lahirunirmalx/discrete-stereo-amp/README.md

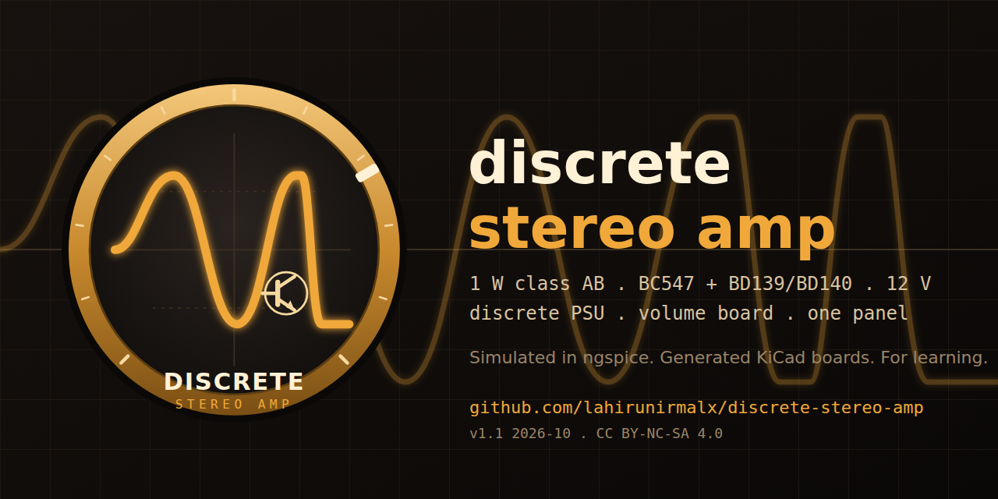
[picture p1: docs/images/banner.png]
discrete stereo amp


# Stereo class-AB amplifier, discrete 12 V supply, volume and headphone boards

A hobby / learning project: a two-channel 1 W class-AB amplifier built from BC547/BC557/BD139/BD140,
its own transformer-fed discrete supply, a volume board and a headphone board, all on one fab panel. It grew
out of a review of a one-transistor "speaker in the collector" amp, which could not be fixed by changing
values. Every number here comes from ngspice; **no board has been built or measured yet** (revision 1.3 is a
prototype design). Release 2 rebuilt the amp front end for ten times less distortion, closed the supply's
regulation loop, added a VU meter tap and the headphone board. Revision 1.3 is the result of a second design
review: an output inductor for stability into capacitive loads, a fail-safe bias trimmer, input protection on
the amp, a correctly sized supply fuse and a headphone switch rated for speaker current.

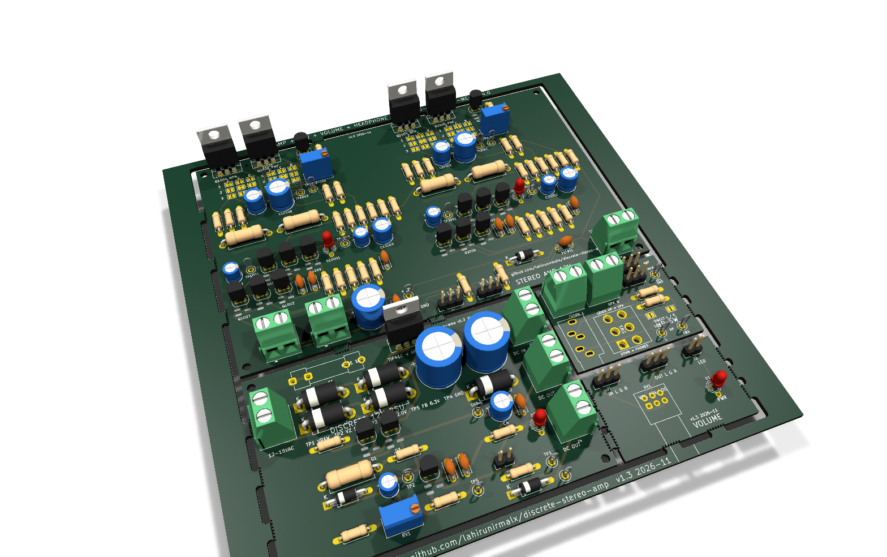
[picture p2: docs/images/panel_3d_iso.png]
Panel, 3D


| Amp | PSU | Volume | Headphone |
|---|---|---|---|
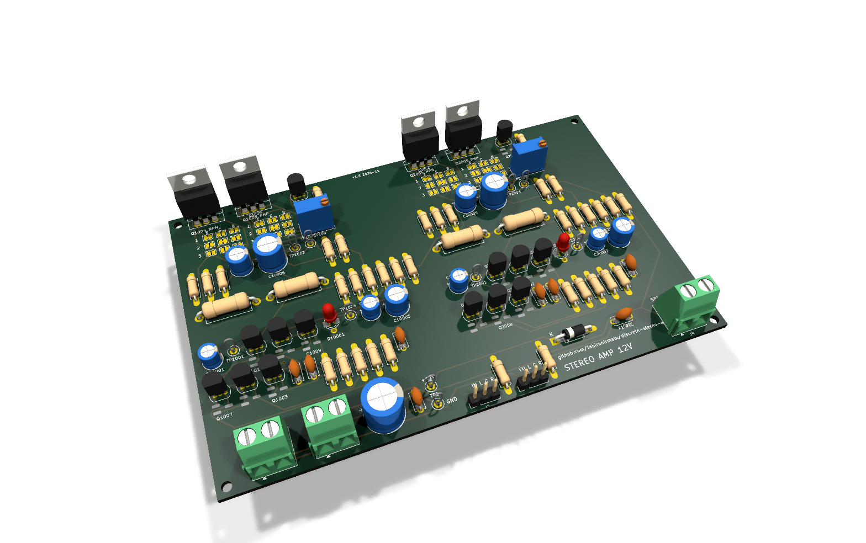
[picture p3: docs/images/amp_3d_iso.png]
Amp 3D
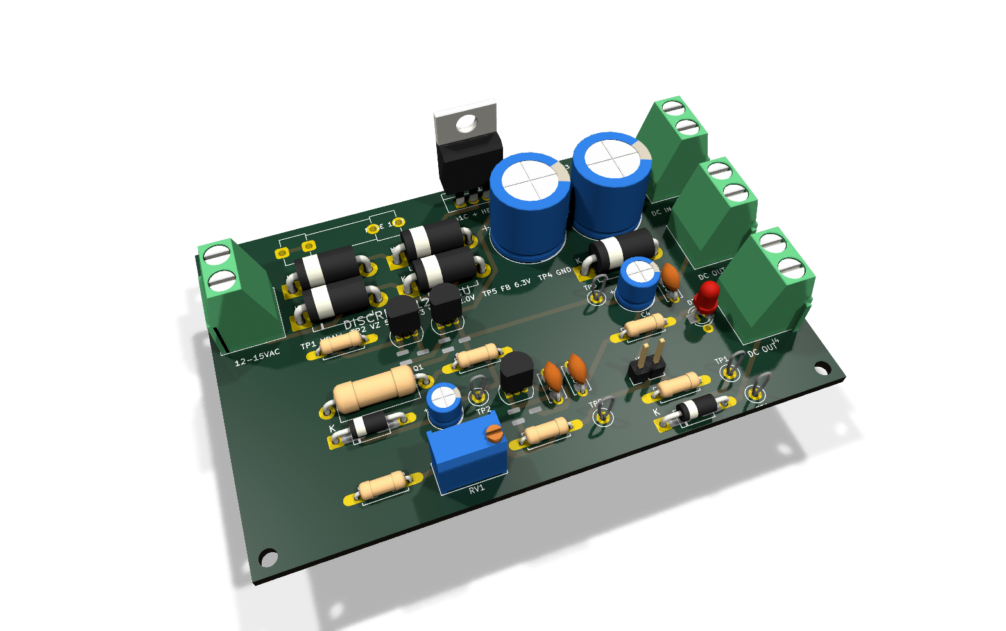
[picture p4: docs/images/psu_3d_iso.png]
PSU 3D
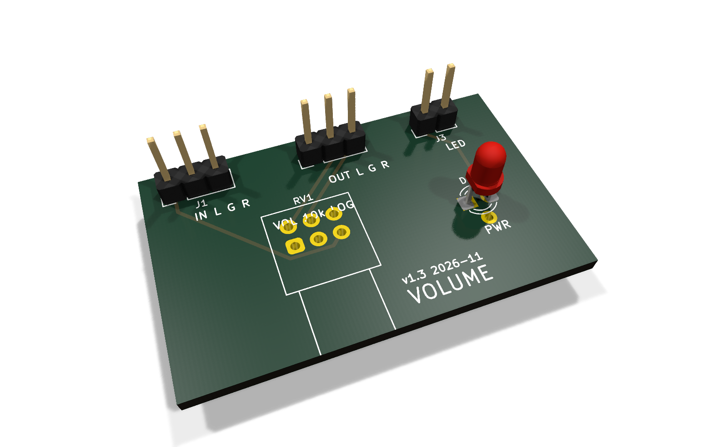
[picture p5: docs/images/vol_3d_iso.png]
Volume 3D
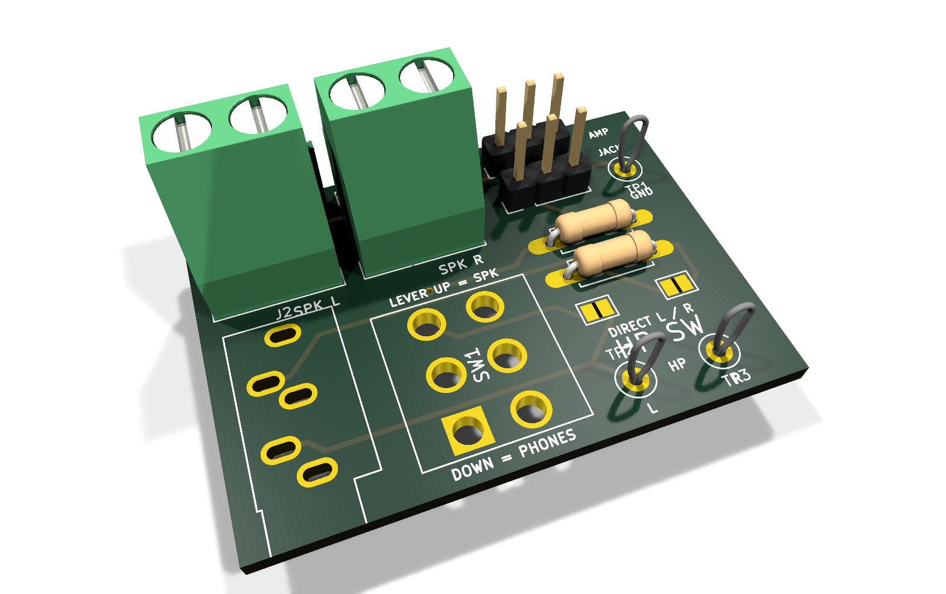
[picture p6: docs/images/hp_3d_iso.png]
Headphone 3D
|  |  |  |  |

More views in [docs/images/](docs/images/): top-down 3D renders and the single-sided layouts. Logo and banner: `logo.svg` / `logo.png` / `logo-1024.png` and `banner.svg` / `banner.png` (1280 x 640, the GitHub social-preview size).

## Schematics

| Amp (both channels) | PSU | Volume | Headphone |
|---|---|---|---|
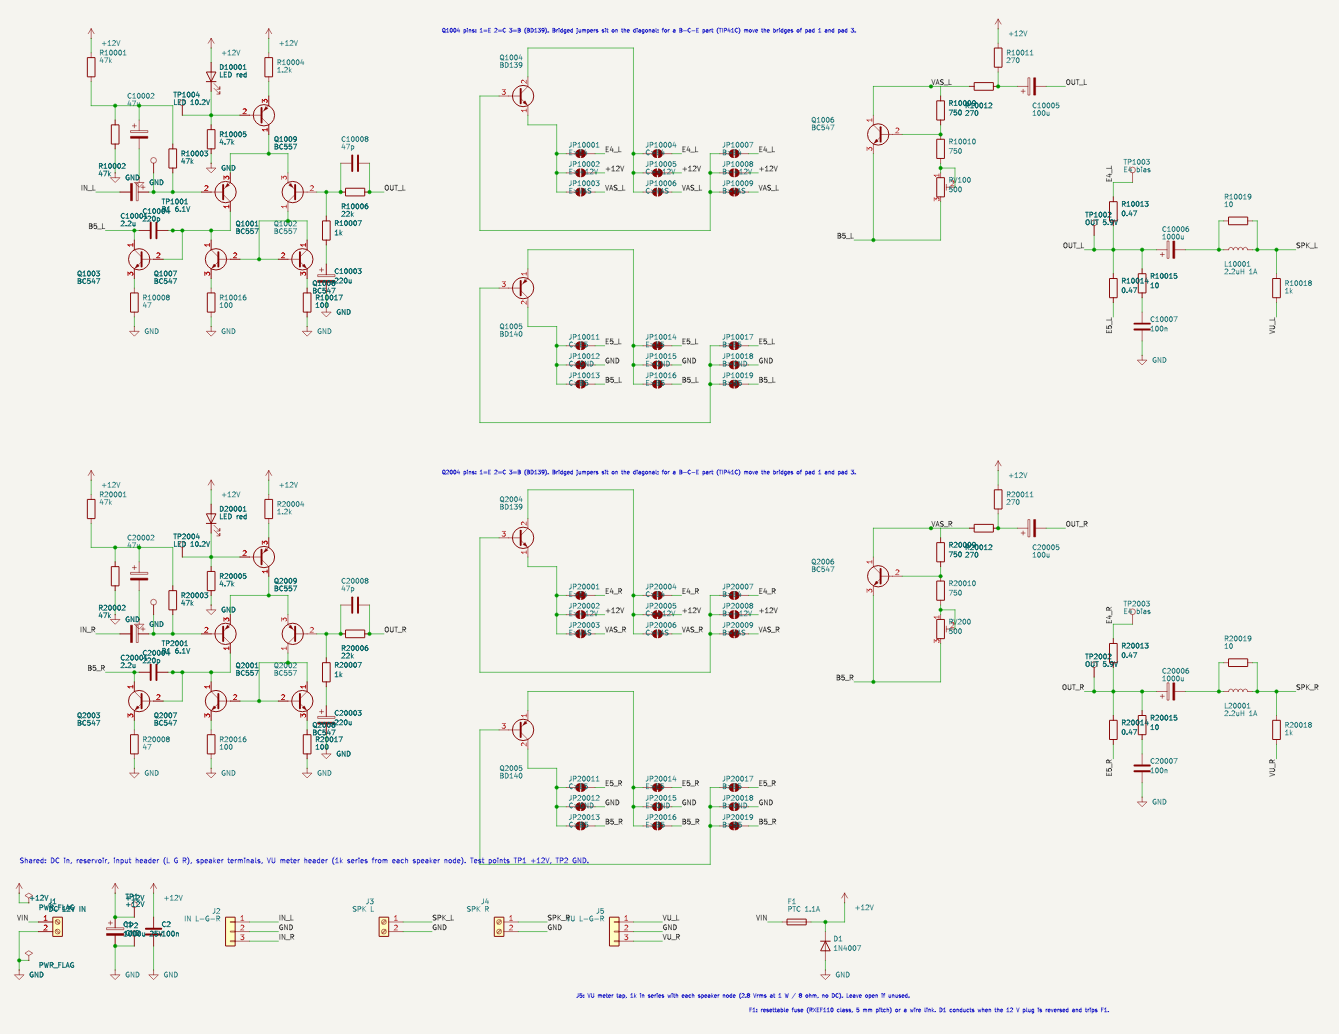
[picture p7: docs/images/amp_schematic.png]
Amp schematic
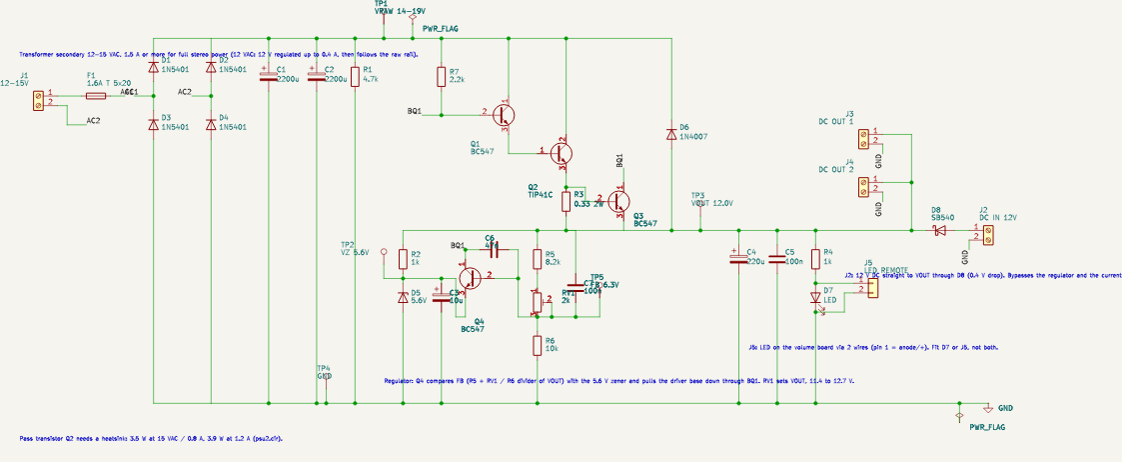
[picture p8: docs/images/psu_schematic.png]
PSU schematic
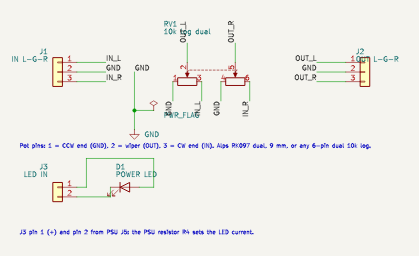
[picture p9: docs/images/vol_schematic.png]
Volume schematic
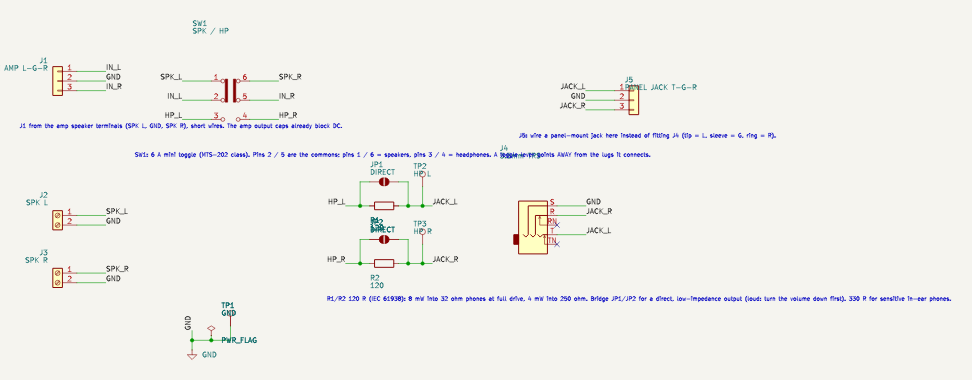
[picture p10: docs/images/hp_schematic.png]
Headphone schematic
|  |  |  |  |

PDFs of all four are in the release zip (`schematics/`).

## Boards (2-layer layouts, top view, both copper layers)

| Amp, wide 134 x 86 mm | Amp, compact 100 x 98 mm | PSU 90 x 58 mm | Volume 42 x 26 mm | Headphone 42 x 30 mm |
|---|---|---|---|---|
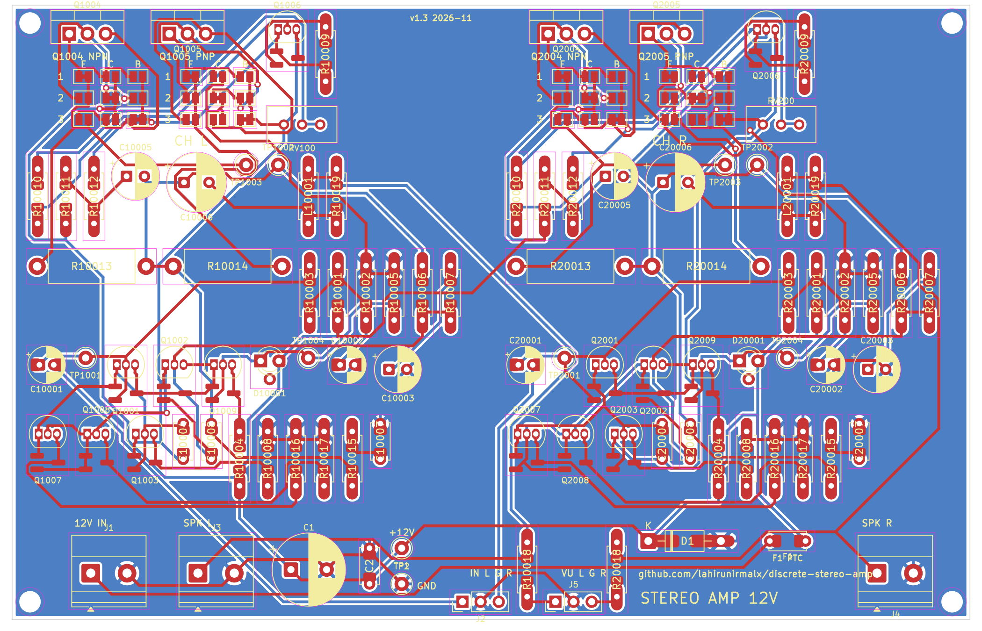
[picture p11: docs/images/amp_pcb_2layer.png]
Amp PCB
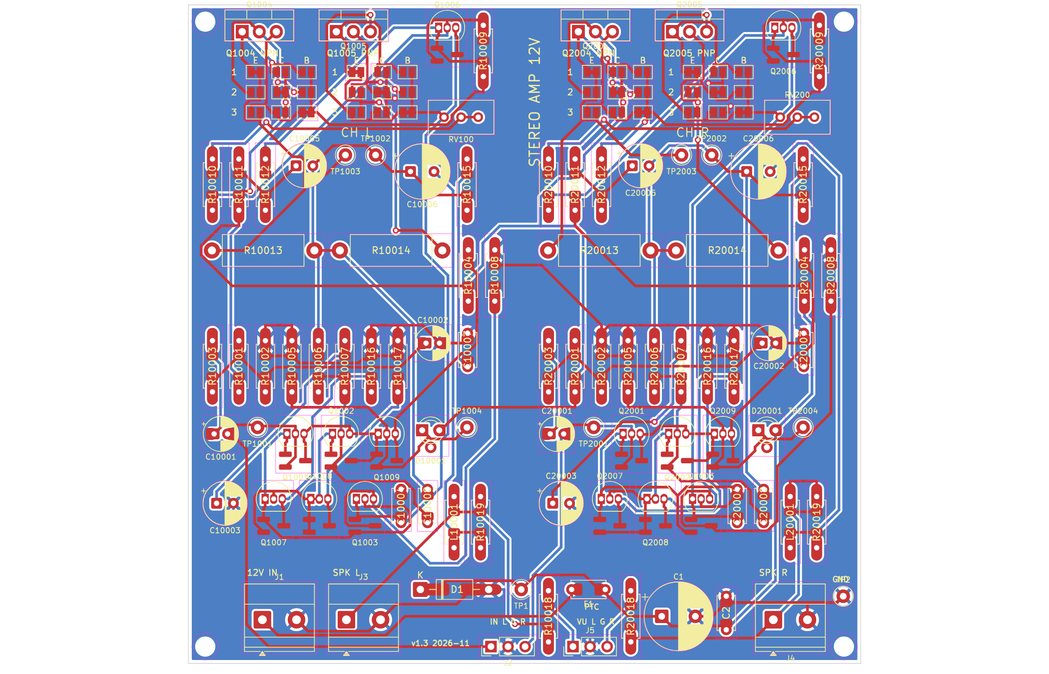
[picture p12: docs/images/amp_compact_pcb_2layer.png]
Compact amp PCB
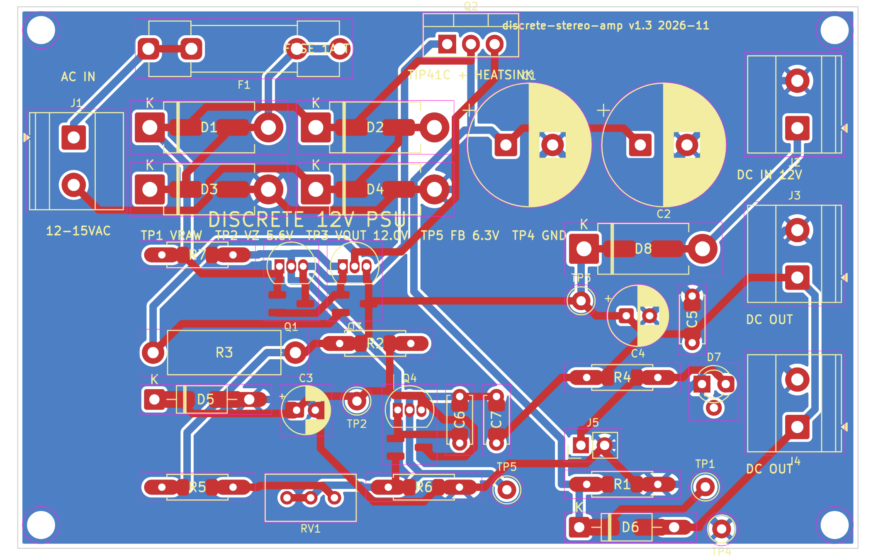
[picture p13: docs/images/psu_pcb_2layer.png]
PSU PCB
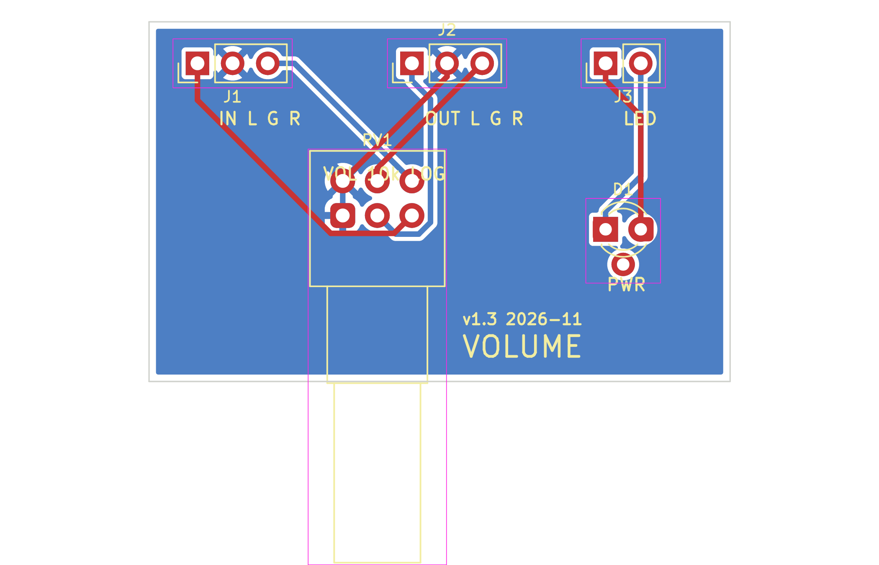
[picture p14: docs/images/vol_pcb_2layer.png]
Volume PCB
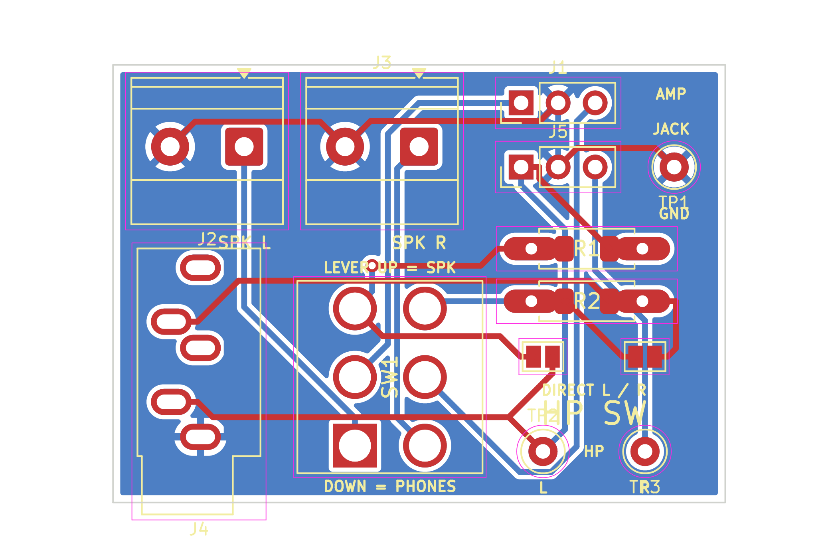
[picture p15: docs/images/hp_pcb_2layer.png]
Headphone PCB
|  |  |  |  |  |

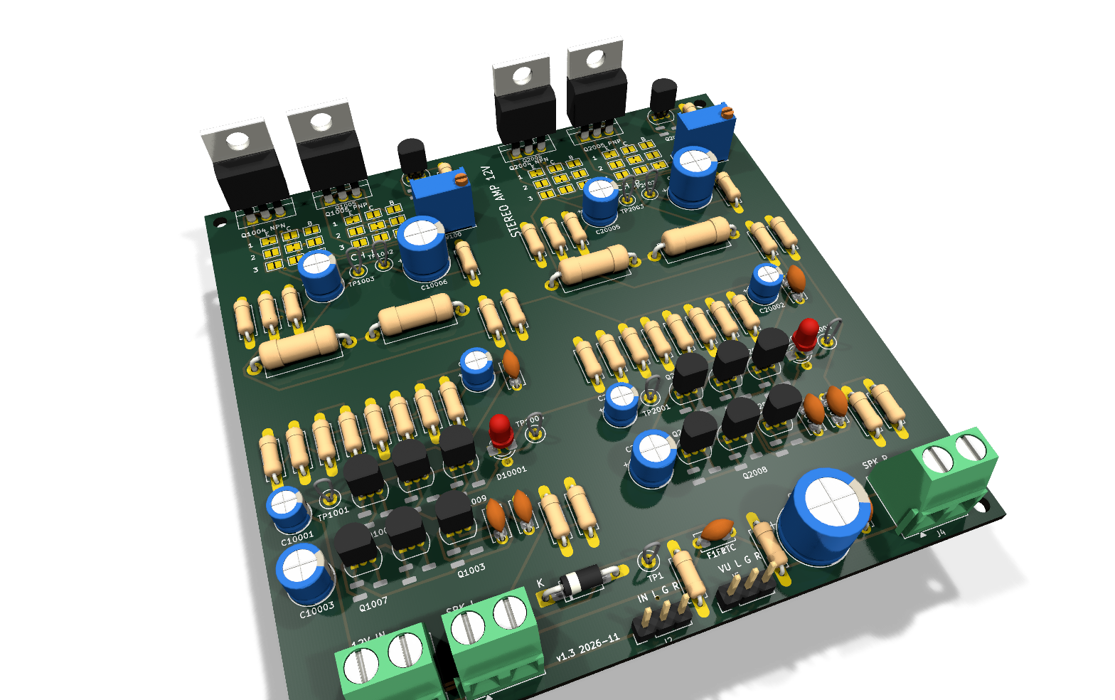
[picture p16: docs/images/amp_compact_3d_iso.png]
Compact amp 3D


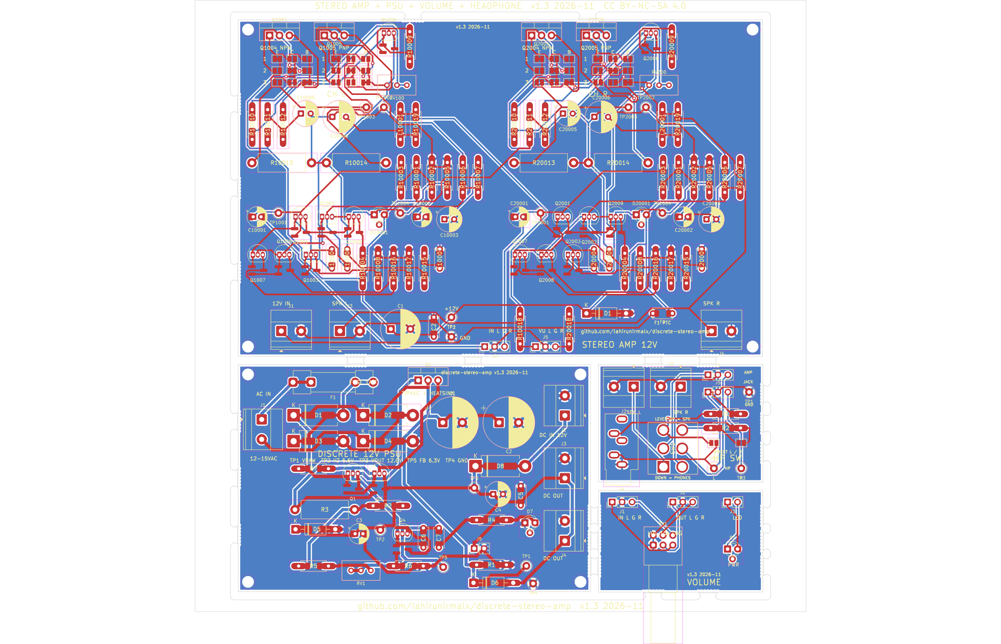
[picture p17: docs/images/panel_2layer.png]
Panel layout


## What it does

| | |
|---|---|
| Output | 1.2 W into 8 ohm and 1.5 W into 4 ohm at the onset of clipping (per channel, 12 V); 0.29 W into 8 ohm at 0.02 to 0.05% THD, 52 mW into 4 ohm at 0.013% |
| Gain / input | 23 (27 dB), 46k input impedance, for a 10k log pot |
| Idle current | output stage 21 mA per channel after setting the trimmer (7 to 10 mV across a 0.47 ohm emitter resistor; trimmer range 2 to 70 mA); about 33 mA per channel from the supply |
| Bandwidth | 20 Hz (8 ohm) / 34 Hz (4 ohm) to 108 kHz, -0.13 dB at 20 kHz |
| Stability | loop phase margin 65 degrees or more for any load from open to 2.2 uF (2.2 uH + 10 ohm output inductor) |
| Protection | amp: resettable fuse + reverse-polarity diode on the 12 V input, bias trimmer limited to 70 mA and fail-safe; PSU: 2 A clamp + 1.6 A slow fuse |
| Supply | 12 to 15 VAC transformer (1.5 A for full power) or 12 V DC in; closed-loop 12.0 V out (trimmer 11.4 to 12.7 V), 0.14 V dip on a 1 A step, 2 A clamp |
| Headphones | DPDT toggle switch speakers / phones, 120 ohm series (8 mW into 32 ohm), DIRECT jumpers, 3.5 mm jack or panel jack header |
| VU meter | 1x3 header on the amp, 1k in series with each speaker node (2.8 Vrms at 1 W) |
| Boards | amp 134 x 86 mm (or the compact 100 x 98 mm variant for the 100 x 100 fab tier), PSU 90 x 58 mm, volume 42 x 26 mm, headphone 42 x 30 mm; 2-layer panel 156 x 156 mm; single-sided variants |
| Parts | 151 through-hole parts with 1206 / SOD / SMA / SOT-23 twins on the same pads; 38 solder jumpers (output pinouts, headphone DIRECT) |

## Design rules this project keeps

1. **Modular.** Every board works alone; none depends on another. Build the amp only, add the volume board or the PSU later.
2. **Your parts, your build.** Every passive has through-hole pads plus a 1206 / SOD / SMA twin; every output transistor sits behind a 3x3 solder-jumper pinout block; the BOM lists at least three substitutes per transistor. Fit what you have.
3. **Debuggable by a beginner.** Every board carries labelled test points with the expected voltage printed next to them, and the bring-up guide walks through them in order.

Any change to this project is checked against these three before it is merged.

## Build it board by board

Every board works on its own; nothing is required by another board.

| You build | You need | What you get |
|---|---|---|
| Amp only | any 12 V DC supply of 1 A (wall adapter, bench supply) into "12V IN"; a phone, PC or DAC into the "IN L G R" header; speakers on the terminals | a working stereo amp; the source's own volume control sets the level (a phone at full volume will clip, so turn it down) |
| Amp + volume board | as above, plus the two 3-pin cables | a volume knob (and the front-panel LED position) |
| Amp + PSU | a 12 to 15 VAC transformer into the PSU, or 12 V DC into its "DC IN"; PSU "DC OUT" to the amp | a regulated, clamped, fused supply with the power LED |
| Amp + headphone board | three wires from the amp's speaker terminals to "FROM AMP", speakers on the headphone board's terminals | a speakers / phones switch and a jack |
| VU meters | any meter on the amp's "VU L G R" header | level display; nothing else changes |
| All four | the panel | the complete desk amp |

Two amp layouts carry the same circuit: the wide one (134 x 86 mm, matches the PSU plus headphone-and-volume
column on the panel) and the compact one (100 x 98 mm, fits JLCPCB's 100 x 100 mm tier when ordered alone).
Choose by price; there is no electrical difference.

## Documents

1. [docs/01-theory-of-operation.md](docs/01-theory-of-operation.md): every block explained for a first build, with the voltages to expect.
2. [docs/02-simulation-results.md](docs/02-simulation-results.md): all the ngspice tables, including the rejected candidates, the release 2 front end and supply (2.7 to 2.9) and the revision 1.3 loop-gain work (2.10).
3. [docs/03-design-review.md](docs/03-design-review.md): what was checked, what was found, what is not verified.
4. [docs/04-build-and-bringup.md](docs/04-build-and-bringup.md): assembly order, first power-up, bias setting, test points, troubleshooting.
5. [ORDER_GUIDE.md](ORDER_GUIDE.md): ordering the panel, substitutes, matching, tolerances.
6. [docs/05-preamp-study.md](docs/05-preamp-study.md): does a preamp stage help a line-level desk amp? (No; where it would.)
7. [docs/KNOWN_ISSUES.md](docs/KNOWN_ISSUES.md) and [docs/CHANGELOG.md](docs/CHANGELOG.md).
8. Interactive: [amp channel in CircuitJS](https://www.falstad.com/circuit/circuitjs.html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,%20VAS,%20Vbe%20multiplier,%20BD139/BD140.%2012%20V,%20Iq%2021%20mA,%201%20W%20into%208R%20at%200.5%25%20THD%0A), [power supply in CircuitJS](https://www.falstad.com/circuit/circuitjs.html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) (text netlists in [docs/circuitjs/](docs/circuitjs/)).
9. [docs/stereo-amp-notes.html](docs/stereo-amp-notes.html): single-file bench-notes page with the verified figures, every sweep table and links to interactive CircuitJS versions of the channel and the supply (download and open locally, or view it through htmlpreview.github.io).

## Files

| Dir | What |
|---|---|
| `sim/` | ngspice decks and results (`sim/README.md`) |
| `kicad/gen_amp.py gen_psu.py gen_vol.py gen_hp.py` | schematic generators (kisch.py writer, common.py helpers and the STAMP); `netcheck.py` proves each netlist matches its deck |
| `kicad/gen_pcb_*.py`, `pcbgen.py` | placement + board builder (hybrid footprints, 2-layer or `--single`) |
| `kicad/build.sh <board> [--single] [--compact]` | place, freerouting (second pass if needed), ground pour, DRC, PNG |
| `kicad/panel/` | KiKit multi-design panel, BOMs (bom_all, bom_shopping, bom_mouser) |
| `kicad/release.sh` | fab package -> `release/stereo-amp-release-<date>.zip` |
| `docs/` | the documents above and `docs/images/` |
| `analysis/` | check-schematic / check-pcb analyzer outputs used by the design review |
| `build_all.sh` | regenerate everything |

Schematic symbol UUIDs are deterministic, so re-running a generator keeps PCB parity. Edit the generators,
not the KiCad files.

## Status

Revision 1.3, 2026-11-10: design complete, simulated, reviewed twice, DRC clean (2-layer boards and panel), unbuilt. The
single-sided amp board needs hand finishing (see known issues).

## License

[CC BY-NC-SA 4.0](LICENSE): build it, modify it, share it with credit; no commercial use of this or any
derived design without the author's written permission.
