lahirunirmalx/discrete-stereo-amp/docs/images/amp_3d_top.png

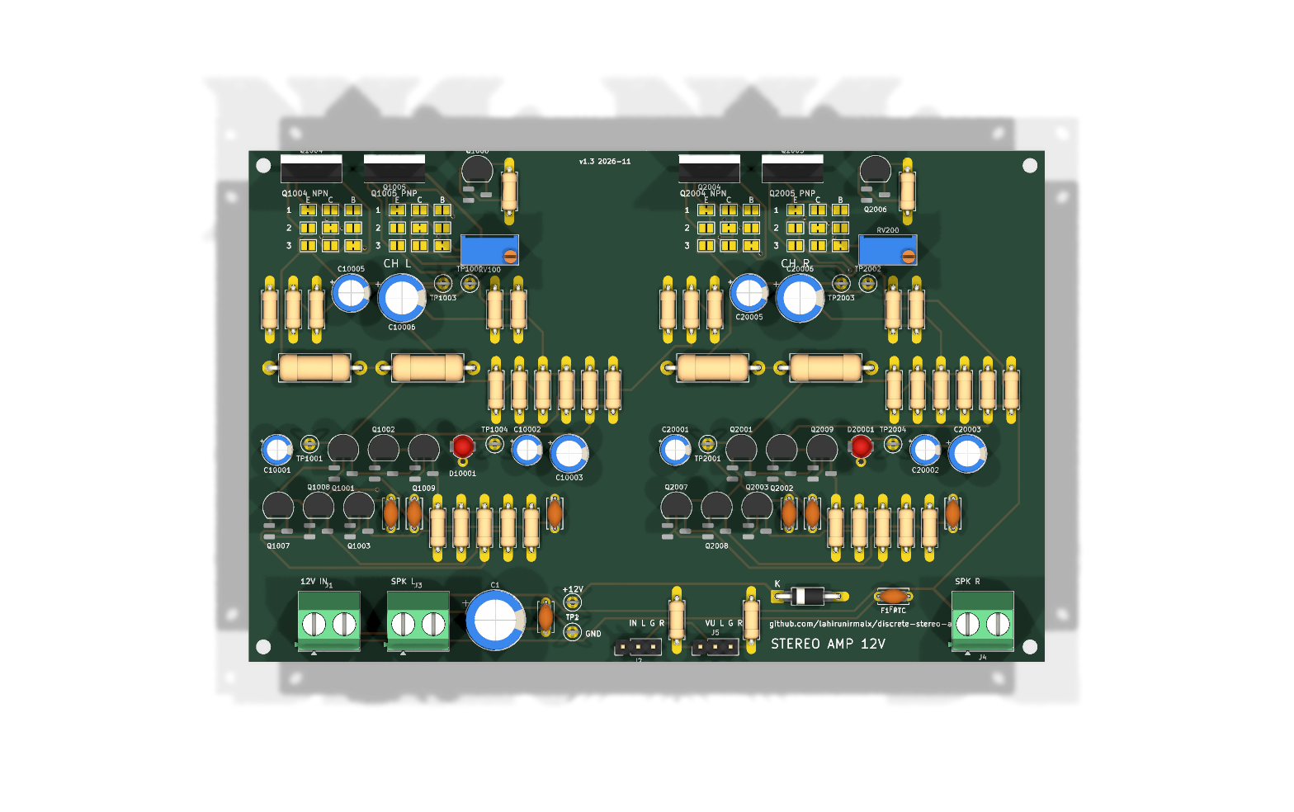
docs/images/amp_3d_top.png
