lahirunirmalx/discrete-stereo-amp/docs/images/amp_pcb_1layer.png

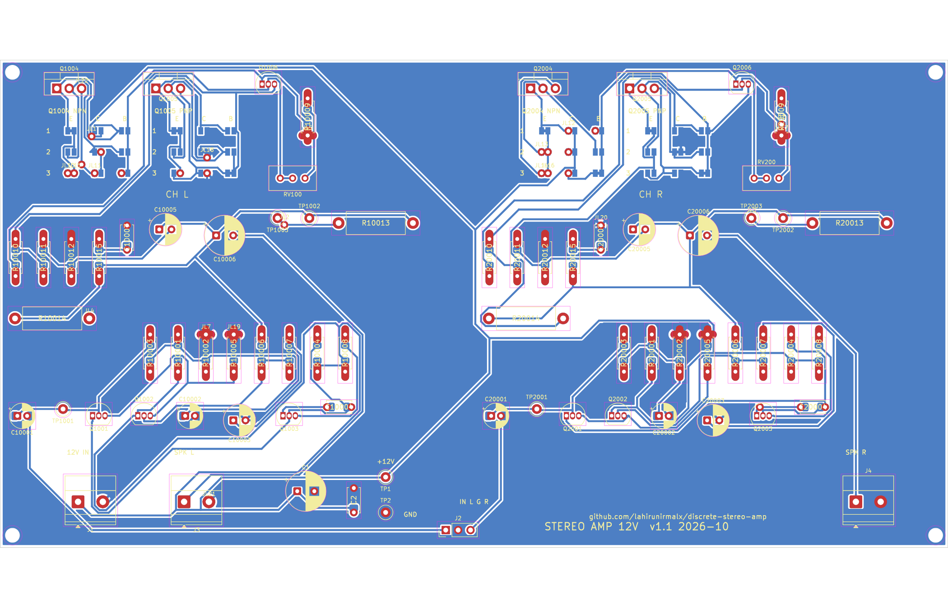
docs/images/amp_pcb_1layer.png
