lahirunirmalx/discrete-stereo-amp/docs/images/hp_3d_top.png

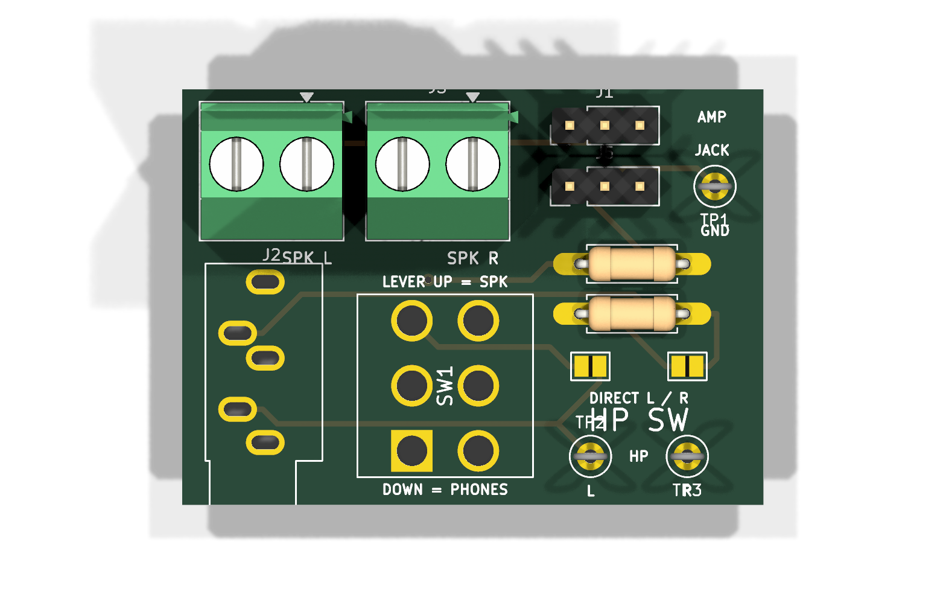
docs/images/hp_3d_top.png
