lahirunirmalx/discrete-stereo-amp/docs/images/hp_pcb_1layer.png

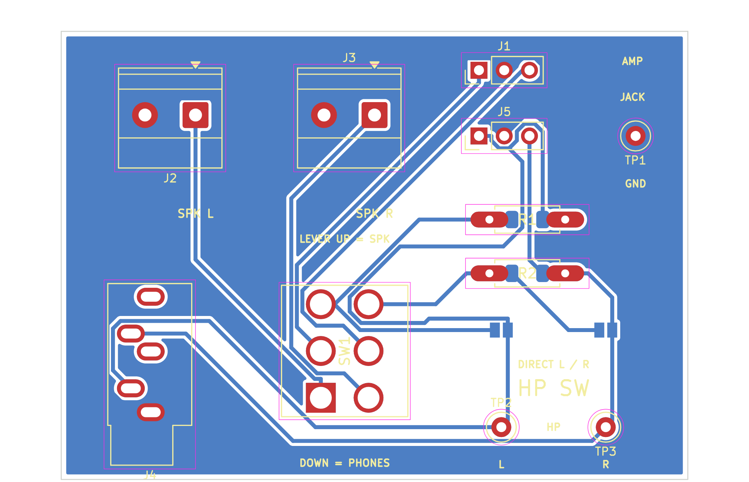
docs/images/hp_pcb_1layer.png
