lahirunirmalx/discrete-stereo-amp/docs/images/panel_3d_top.png

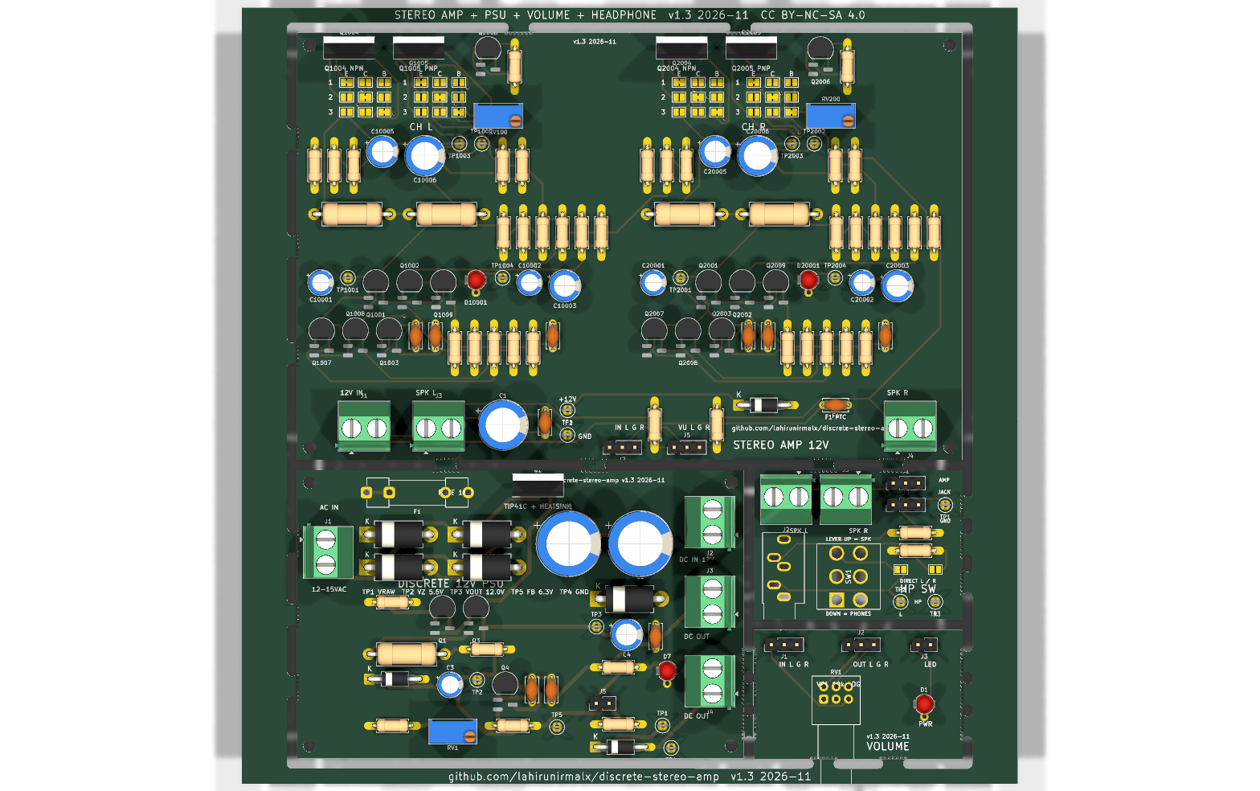
docs/images/panel_3d_top.png
