lahirunirmalx/discrete-stereo-amp/docs/images/psu_3d_top.png

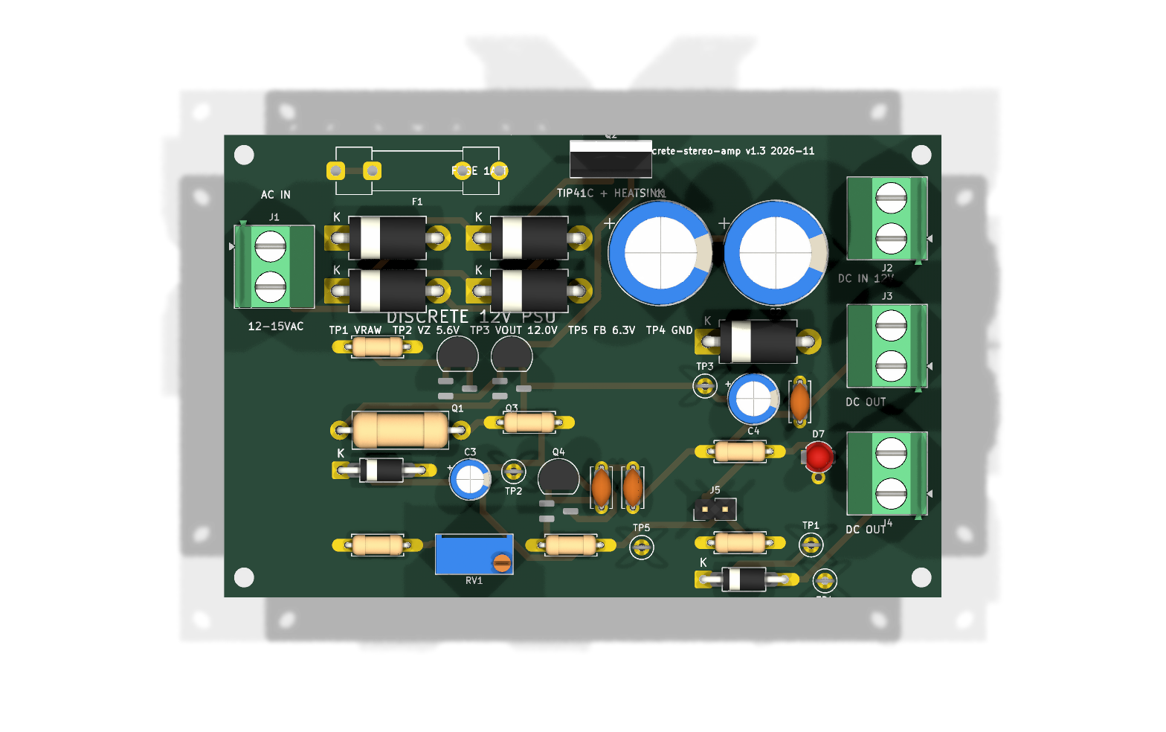
docs/images/psu_3d_top.png
