lahirunirmalx/discrete-stereo-amp/docs/images/psu_pcb_1layer.png

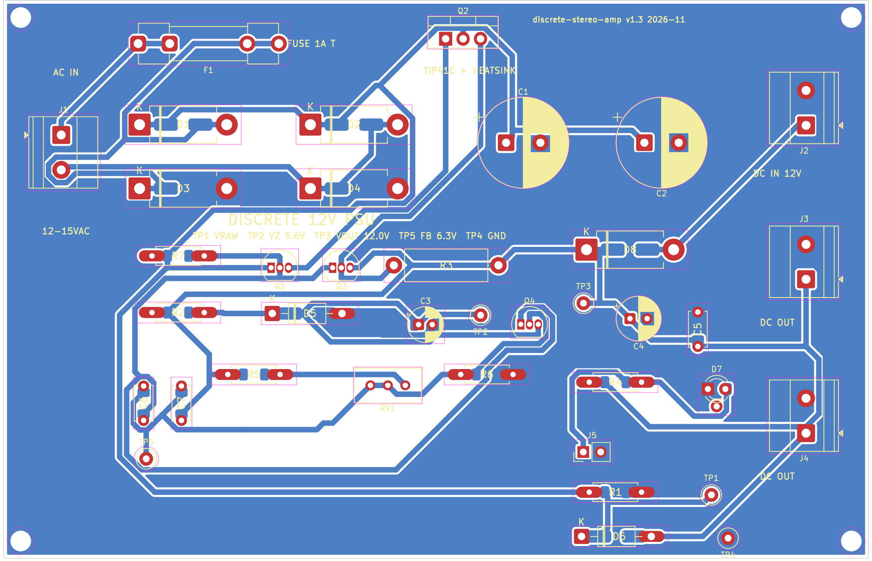
docs/images/psu_pcb_1layer.png
