lahirunirmalx/discrete-stereo-amp/docs/images/vol_3d_top.png

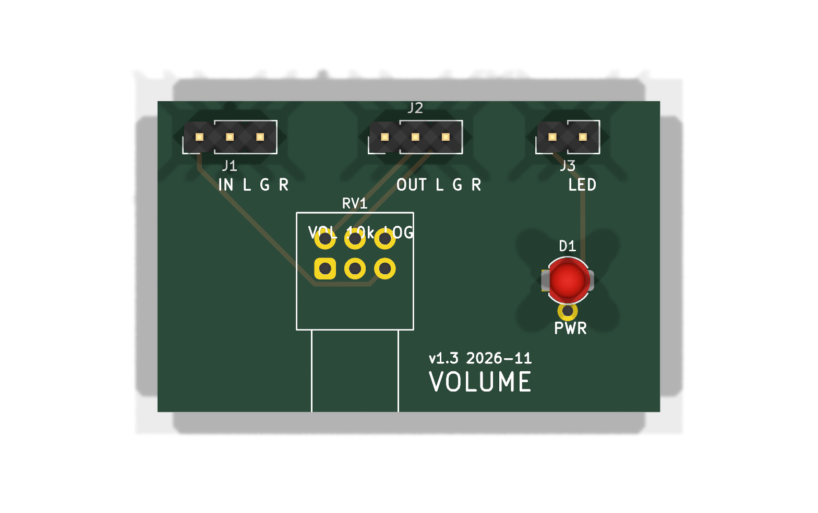
docs/images/vol_3d_top.png
