lahirunirmalx/discrete-stereo-amp/docs/images/vol_pcb_1layer.png

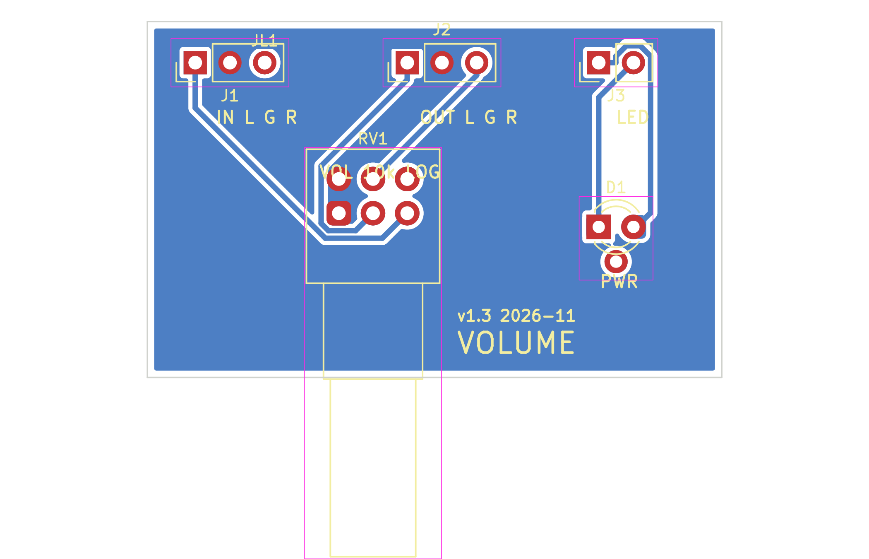
docs/images/vol_pcb_1layer.png
