lahirunirmalx/discrete-stereo-amp/kicad/panel/bom_shopping.md

# Shopping list (all four boards, one set)

| Kind | Value | Qty | Package | Spec |
|---|---|---|---|---|
| capacitor | 1000u | 2 | CP_Radial_D8.0mm_P3.50mm | 1000 uF, 16 V, low ESR preferred |
| capacitor | 1000u 25V | 1 | CP_Radial_D10.0mm_P5.00mm | 1000 uF, 25 V, 10 mm can, 5 mm pitch |
| capacitor | 100n | 5 | ceramic disc 5 mm | 100 nF X7R |
| capacitor | 100u | 2 | CP_Radial_D6.3mm_P2.50mm | 100 uF, 16 V |
| capacitor | 10u | 1 | electrolytic 5 mm radial | 10 uF, 16 V |
| capacitor | 2.2u | 2 | electrolytic 5 mm radial | 2.2 uF, 25 V, 20 percent |
| capacitor | 2200u | 2 | CP_Radial_D13.0mm_P5.00mm | 2200 uF, 25 V (35 V if the transformer is 15 VAC) |
| capacitor | 220p | 2 | ceramic disc 5 mm | 220 pF C0G/NP0, 10 percent, 50 V |
| capacitor | 220u | 3 | CP_Radial_D6.3mm_P2.50mm | 220 uF, 16 V |
| capacitor | 47n | 1 | ceramic disc 5 mm | 47 nF X7R or film, 50 V |
| capacitor | 47p | 2 | ceramic disc 5 mm | 47 pF C0G/NP0, 10 percent, 50 V |
| capacitor | 47u | 2 | electrolytic 5 mm radial | 47 uF, 16 V |
| connector | 1x2 pin header 2.54 mm | 2 | PinHeader_1x02_P2.54mm_Vertical |  |
| connector | 1x3 pin header 2.54 mm | 6 | PinHeader_1x03_P2.54mm_Vertical |  |
| connector | 2-pin screw terminal 5.08 mm | 9 | TerminalBlock_Phoenix_MKDS-1,5-2-5.08_1x02_P5.08mm_Horizontal |  |
| connector | 3.5 mm TRS jack, CUI SJ1-3535NG | 1 | Jack_3.5mm_CUI_SJ1-3535NG_Horizontal |  |
| diode / LED | 1N4007 | 2 | DO-41 | 1 A, 50 V or more |
| diode / LED | 1N5401 | 4 | DO-201AD | 3 A, 100 V or more |
| diode / LED | 5.6V | 1 | DO-41 | 5.6 V, 0.5 W, 5 percent |
| diode / LED | LED | 1 | 3 mm LED (or two small diodes via the middle hole M) | 3 mm LED, any colour |
| diode / LED | LED red | 2 | 3 mm LED (or two small diodes via the middle hole M) |  |
| diode / LED | POWER LED | 1 | 3 mm LED (or two small diodes via the middle hole M) | 3 mm LED, any colour |
| diode / LED | SB540 | 1 | DO-201AD | 5 A Schottky, 40 V |
| fuse | 1.6A T 5x20 | 1 | Fuseholder_Clip-5x20mm_Littelfuse_100_Inline_P20.50x4.60mm_D1.30mm_Horizontal | 1.6 A slow-blow (T) 5x20 mm + 2 clips |
| fuse | PTC 1.1A | 1 | ceramic disc 5 mm | resettable fuse, 1.1 A hold / 2.2 A trip, 16 V or more, 5 mm pitch |
| inductor | 2.2uH 1A | 2 | axial 1/4 W | 2.2 uH, 1 A or more, under 0.3 ohm, axial |
| potentiometer / trimmer | 10k log dual | 1 | Potentiometer_Alps_RK097_Dual_Horizontal | 10k log (A103) dual, 6 pins, 9 mm |
| potentiometer / trimmer | 2k | 1 | Potentiometer_Bourns_3296W_Vertical | 2k trimmer, multi-turn preferred (3296W) |
| potentiometer / trimmer | 500 | 2 | Potentiometer_Bourns_3296W_Vertical | 500 ohm, multi-turn preferred (3296W / 3386P) |
| resistor | 0.33 2W | 1 | R_Axial_DIN0414_L11.9mm_D4.5mm_P15.24mm_Horizontal | 0.33 ohm, 3 W, 5 percent |
| resistor | 0.47 | 4 | R_Axial_DIN0414_L11.9mm_D4.5mm_P15.24mm_Horizontal | 5 percent, 2 W, 0.47 ohm |
| resistor | 1.2k | 2 | axial 1/4 W | 1.2k, 1 percent, 1/4 W |
| resistor | 10 | 4 | axial 1/4 W | 5 percent, 1/4 W |
| resistor | 100 | 4 | axial 1/4 W | 100 ohm, 1 percent, 1/4 W |
| resistor | 10k | 1 | axial 1/4 W | 10k, 1 percent, 1/4 W |
| resistor | 120 | 2 | axial 1/4 W | 120 ohm, 1 percent, 1/4 W |
| resistor | 1k | 6 | axial 1/4 W | 1 percent, 1/4 W |
| resistor | 2.2k | 1 | axial 1/4 W | 2.2k, 0.5 W |
| resistor | 22k | 2 | axial 1/4 W | 1 percent, 1/4 W |
| resistor | 270 | 4 | axial 1/4 W | 5 percent, 1/4 W |
| resistor | 4.7k | 3 | axial 1/4 W | 5 percent, 1/4 W |
| resistor | 47 | 2 | axial 1/4 W | 5 percent, 1/4 W |
| resistor | 47k | 6 | axial 1/4 W | 5 percent, 1/4 W |
| resistor | 750 | 4 | axial 1/4 W | 750 ohm, 1 percent, 1/4 W |
| resistor | 8.2k | 1 | axial 1/4 W | 8.2k, 1 percent, 1/4 W |
| switch | SPK / HP | 1 | DPDT mini toggle, 2 x 3 lugs 4.7 x 4.8 mm | DPDT on-on miniature toggle, 2 A or more, lugs 4.7 x 4.8 mm |
| test point | test point loop (or a bare wire loop) | 18 | TestPoint_Loop_D2.50mm_Drill1.0mm |  |
| transistor | BC547 | 11 | TO-92 | hFE 200-450 |
| transistor | BC557 | 6 | TO-92 | hFE 200-450 (B or C grade) |
| transistor | BD139 | 2 | TO-220-3_Vertical | hFE 100-250 (-16 grade), 1.5 A, 80 V |
| transistor | BD140 | 2 | TO-220-3_Vertical | hFE 100-250 (-16 grade), 1.5 A, 80 V |
| transistor | TIP41C | 1 | TO-220-3_Vertical | 6 A, 100 V, TO-220 on a heatsink |

Plus 38 solder jumpers (copper pads only, no part), M2.5 screws for the 8 mounting holes, a 12-15 VAC transformer, hook-up wire.
Fit ONE power LED (PSU D7 or volume D1), so the LED count can drop by one.
