lahirunirmalx/discrete-stereo-amp/kicad/amp/bom_amp.csv

board | qty | refs | value | through_hole | smd_alternative | tolerance_rating | substitutes | matching_note
amp | 2 | C10006 C20006 | 1000u | CP_Radial_D8.0mm_P3.50mm |  | 1000 uF, 16 V, low ESR preferred | 1000u to 2200u 16 V | Output coupling: -3 dB at 34 Hz into 4 ohm, 20 Hz into 8 ohm; 2200u halves those.
amp | 1 | C1 | 1000u 25V | CP_Radial_D10.0mm_P5.00mm |  | 1000 uF, 25 V, 10 mm can, 5 mm pitch | 1000u to 2200u 25 V; a 16 V part only if the amp never runs from the PSU board | Rail reservoir. 25 V so a regulator fault on the PSU (output at the raw rail, 19 to 21 V) does not burst it.
amp | 1 | C2 | 100n | ceramic disc 5 mm | 1206 | 100 nF X7R | 100n | Rail decoupling.
amp | 2 | C10007 C20007 | 100n | ceramic disc 5 mm | 1206 | 100 nF X7R, 50 V | 100n X7R or film | Zobel.
amp | 2 | C10005 C20005 | 100u | CP_Radial_D6.3mm_P2.50mm |  | 100 uF, 16 V | 47u to 220u | Bootstrap.
amp | 2 | C10001 C20001 | 2.2u | electrolytic 5 mm radial | 1206 MLCC | 2.2 uF, 25 V, 20 percent | 2.2u electrolytic (+ to the base side) or 2.2u film / 1206 X7R | Input coupling; -3 dB with the 46k input is 1.6 Hz, value is not critical.
amp | 2 | C10004 C20004 | 220p | ceramic disc 5 mm | 1206 | 220 pF C0G/NP0, 10 percent, 50 V | 220p C0G; 1206 C0G; 330p also stable | Miller compensation, works together with the 47p lead capacitor C8. Keep 220 to 330 pF, C0G only, never Y5V.
amp | 2 | C10003 C20003 | 220u | CP_Radial_D6.3mm_P2.50mm |  | 220 uF, 16 V | 100u to 470u | Feedback return: sets the low-frequency gain roll-off (0.7 Hz at 220u).
amp | 2 | C10008 C20008 | 47p | ceramic disc 5 mm | 1206 | 47 pF C0G/NP0, 10 percent, 50 V | 47p C0G; 33p to 68p; 1206 C0G | Lead capacitor across the 22k feedback resistor: sets the -3 dB point (120 kHz) and the square-wave overshoot (5.7 percent). Not optional.
amp | 2 | C10002 C20002 | 47u | electrolytic 5 mm radial | 1206 MLCC | 47 uF, 16 V | 22u to 100u electrolytic | Bias decoupling.
amp | 1 | D1 | 1N4007 | DO-41 | SMA | 1 A, 50 V or more | 1N4007 (fitted); 1N4001 to 1N4006; 1N5819; S1M / SS14 in SMA | Reverse-polarity clamp across the rail behind F1 (cathode to +12 V). Carries nothing in normal use.
amp | 2 | D10001 D20001 | LED red | 3 mm LED (or two small diodes via the middle hole M) | 1206 LED | 5 percent / 20 percent, standard
amp | 1 | F1 | PTC 1.1A | ceramic disc 5 mm | 1206 | resettable fuse, 1.1 A hold / 2.2 A trip, 16 V or more, 5 mm pitch | RXEF110 (fitted); MF-R110; RUEF135 (1.35 A); a wire link if your 12 V source is already fused | In series with the 12 V input. Trips when D1 conducts on a reversed plug or when the board is shorted. About 0.2 ohm.
amp | 1 | J1 | DC 12V IN | TerminalBlock_Phoenix_MKDS-1,5-2-5.08_1x02_P5.08mm_Horizontal |  | 5.08 mm screw terminal or 2.54 mm header | Phoenix MKDS 1.5/2; any 5.08 mm 2-pin block
amp | 1 | J2 | IN L-G-R | PinHeader_1x03_P2.54mm_Vertical |  | 5.08 mm screw terminal or 2.54 mm header | Phoenix MKDS 1.5/2; any 5.08 mm 2-pin block
amp | 1 | J3 | SPK L | TerminalBlock_Phoenix_MKDS-1,5-2-5.08_1x02_P5.08mm_Horizontal |  | 5.08 mm screw terminal or 2.54 mm header | Phoenix MKDS 1.5/2; any 5.08 mm 2-pin block
amp | 1 | J4 | SPK R | TerminalBlock_Phoenix_MKDS-1,5-2-5.08_1x02_P5.08mm_Horizontal |  | 5.08 mm screw terminal or 2.54 mm header | Phoenix MKDS 1.5/2; any 5.08 mm 2-pin block
amp | 1 | J5 | VU L-G-R | PinHeader_1x03_P2.54mm_Vertical |  | 5 percent / 20 percent, standard
amp | 2 | L10001 L20001 | 2.2uH 1A | axial 1/4 W | 1206 | 2.2 uH, 1 A or more, under 0.3 ohm, axial | 2.2 uH axial choke (fitted); 1 to 4.7 uH; 12 turns of 0.6 mm enamelled wire wound on R19's body (then leave L empty and solder the coil ends to R19's leads); 1206 2.2 uH rated 1 A | Output inductor: isolates cable and crossover capacitance from the feedback loop. Phase margin 65 deg or more with it, 20 deg at 47-100 nF without it. A wire link works for short 8 ohm speaker leads only.
amp | 2 | Q1003 Q2003 | BC547 | TO-92 | SOT-23 (2-layer board only) | hFE 200-450 | BC547B/C (fitted); BC548B/C; BC549C or BC550C (lower noise); BC337-25 (800 mA); 2N3904 or PN2222A only turned 180 deg (E-B-C pinout) | NPN voltage amplifier (VAS). No matching needed.
amp | 2 | Q1006 Q2006 | BC547 | TO-92 | SOT-23 (2-layer board only) | hFE 200-450 | BC547B/C (fitted); BC548B/C; BC549C or BC550C (lower noise); BC337-25 (800 mA); 2N3904 or PN2222A only turned 180 deg (E-B-C pinout) | Vbe multiplier: any of the BC547 family. Mount it touching or next to the output transistors so it tracks their temperature.
amp | 4 | Q1007 Q1008 Q2007 Q2008 | BC547 | TO-92 | SOT-23 (2-layer board only) | hFE 200-450 (B or C grade) | BC547B/C (fitted); BC548B/C; BC549C or BC550C (lower noise); BC337-25 (800 mA); 2N3904 or PN2222A only turned 180 deg (E-B-C pinout) | Current-mirror pair: same part number and grade for Q7 and Q8 of a channel, from one strip; the 100 ohm emitter resistors hide the rest.
amp | 4 | Q1001 Q1002 Q2001 Q2002 | BC557 | TO-92 | SOT-23 (2-layer board only) | hFE 200-450 (B or C grade) | BC557B/C (fitted); BC558B/C; BC559C or BC560C; BC327-25; 2N3906 or PN2907A only turned 180 deg (E-B-C pinout) | PNP differential pair: fit the SAME part number AND grade for Q1 and Q2 of a channel, ideally from one strip. 10 mV Vbe mismatch only shifts the midpoint 0.23 V, so a DMM hFE match within 10 percent is plenty.
amp | 2 | Q1009 Q2009 | BC557 | TO-92 | SOT-23 (2-layer board only) | hFE 200-450 | BC557B/C (fitted); BC558B/C; BC559C or BC560C; BC327-25; 2N3906 or PN2907A only turned 180 deg (E-B-C pinout) | Tail current source. No matching.
amp | 2 | Q1004 Q2004 | BD139 | TO-220-3_Vertical |  | hFE 100-250 (-16 grade), 1.5 A, 80 V | BD139-16 (fitted, E-C-B, bridges on the diagonal); BD135 or BD137 (E-C-B, same bridges); TIP41C or TIP31C (B-C-E: move the pad-1 and pad-3 bridges); BD243C (B-C-E, same move); BC337-40 for low power only (C-B-E: bridges 1->C 2->B 3->E) | Complementary pair: use the same hFE grade for Q4 and Q5 (both -16, or both -10). Feedback corrects up to about 30 percent hFE difference; the trimmer corrects the Vbe difference. At hFE 40 the 4 ohm channel clips at 0.2 W, at 120 it makes 1.3 W.
amp | 2 | Q1005 Q2005 | BD140 | TO-220-3_Vertical |  | hFE 100-250 (-16 grade), 1.5 A, 80 V | BD140-16 (fitted, E-C-B); BD136 or BD138 (E-C-B); TIP42C or TIP32C (B-C-E: move pad-1/pad-3 bridges); BD244C (B-C-E); BC327-40 low power only (C-B-E) | See Q4. Fit both channels with the same four part numbers so L and R sound the same.
amp | 4 | R10013 R10014 R20013 R20014 | 0.47 | R_Axial_DIN0414_L11.9mm_D4.5mm_P15.24mm_Horizontal |  | 5 percent, 2 W, 0.47 ohm | 0.47R 2 W metal oxide or wirewound; 0.5R or 0.39R also fine (both channels the same) | Emitter resistors: match within 5 percent between Q4 and Q5 of one channel.
amp | 2 | R10004 R20004 | 1.2k | axial 1/4 W | 1206 | 1.2k, 1 percent, 1/4 W | 1.2k metal film; 1206 1 percent | Sets the tail current with the LED (1 mA). 1k gives 1.15 mA, 1.5k gives 0.8 mA; both fine.
amp | 2 | R10015 R20015 | 10 | axial 1/4 W | 1206 | 5 percent, 1/4 W | same value, any type
amp | 2 | R10019 R20019 | 10 | axial 1/4 W | 1206 | 10 ohm, 5 percent, 1/4 W (1/2 W if you can) | 10R; 4.7R to 22R | Damps the output inductor.
amp | 4 | R10016 R10017 R20016 R20017 | 100 | axial 1/4 W | 1206 | 100 ohm, 1 percent, 1/4 W | 100R metal film; 1206 1 percent | Mirror emitter degeneration: same value for R16 and R17 of a channel.
amp | 2 | R10007 R20007 | 1k | axial 1/4 W | 1206 | 1 percent, 1/4 W | 1k metal film; 1206 1 percent | Gain-setting partner of R6: 1 percent.
amp | 2 | R10018 R20018 | 1k | axial 1/4 W | 1206 | 1k, 5 percent, 1/4 W | 1k; 2.2k if the VU meter is too sensitive | VU meter tap: 1k in series with the speaker node to header J5. No effect when J5 is unused.
amp | 2 | R10006 R20006 | 22k | axial 1/4 W | 1206 | 1 percent, 1/4 W | 22k metal film; 1206 1 percent | Sets the gain with R7 (1 + 22k/1k = 23). Use 1 percent so left and right match within 2 percent.
amp | 4 | R10011 R10012 R20011 R20012 | 270 | axial 1/4 W | 1206 | 5 percent, 1/4 W | same value, any type
amp | 2 | R10005 R20005 | 4.7k | axial 1/4 W | 1206 | 5 percent, 1/4 W | same value, any type
amp | 2 | R10008 R20008 | 47 | axial 1/4 W | 1206 | 5 percent, 1/4 W | same value, any type
amp | 6 | R10001 R10002 R10003 R20001 R20002 R20003 | 47k | axial 1/4 W | 1206 | 5 percent, 1/4 W | 47k | Bias divider and base feed: 5 percent moves the midpoint less than 0.3 V.
amp | 2 | RV100 RV200 | 500 | Potentiometer_Bourns_3296W_Vertical |  | 500 ohm, multi-turn preferred (3296W / 3386P) | 500R 3296W (fitted); 470R or 500R single-turn 3386P; 1k works but half the travel is below zero bias | In the base-emitter leg: fully anticlockwise = minimum bias, fully clockwise = 70 mA at most, an open wiper = minimum bias. Set 7-10 mV across the 0.47 ohm emitter resistor (TP3 to TP2).
amp | 4 | R10009 R10010 R20009 R20010 | 750 | axial 1/4 W | 1206 | 750 ohm, 1 percent, 1/4 W | 750R metal film; 680R or 820R for both (same value in both positions) | Vbe multiplier: R9 collector to base, R10 base to emitter in series with the trimmer.
amp | 1 | TP1 | +12V | TestPoint_Loop_D2.50mm_Drill1.0mm |  | 5 percent / 20 percent, standard
amp | 2 | TP1001 TP2001 | B1 6.1V | TestPoint_Loop_D2.50mm_Drill1.0mm |  | 5 percent / 20 percent, standard
amp | 2 | TP1003 TP2003 | E4 bias | TestPoint_Loop_D2.50mm_Drill1.0mm |  | 5 percent / 20 percent, standard
amp | 1 | TP2 | GND | TestPoint_Loop_D2.50mm_Drill1.0mm |  | 5 percent / 20 percent, standard
amp | 2 | TP1004 TP2004 | LED 10.2V | TestPoint_Loop_D2.50mm_Drill1.0mm |  | 5 percent / 20 percent, standard
amp | 2 | TP1002 TP2002 | OUT 5.9V | TestPoint_Loop_D2.50mm_Drill1.0mm |  | 5 percent / 20 percent, standard
