lahirunirmalx/discrete-stereo-amp/kicad/panel/bom_mouser.csv

Mfr Part Number (Input) | Manufacturer Part Number | Mouser Part Number | Manufacturer Name | Description | Quantity 1 | Unit Price 1 | Quantity 2 | Unit Price 2 | Quantity 3 | Unit Price 3 | Quantity 4 | Unit Price 4 | Quantity 5 | Unit Price 5 | Order Quantity | Order Unit Price | Min./Mult. | Availability | Lead Time in Days | Lifecycle | NCNR | RoHS | Pb Free | Package Type | Datasheet URL | Product Image | Design Risk
UVR1C102MED |  |  | Nichicon | 1000 uF 16 V radial 8x11.5 mm, 3.5 mm pitch [1000u] |  |  |  |  |  |  |  |  |  |  | 2
UVR1E102MPD |  |  | Nichicon | 1000 uF 25 V radial 10x20 mm, 5 mm pitch [1000u 25V] |  |  |  |  |  |  |  |  |  |  | 1
C320C104K5R5TA |  |  | KEMET | 100 nF X7R 50 V radial 2.5 mm [100n] |  |  |  |  |  |  |  |  |  |  | 5
UVR1C101MDD |  |  | Nichicon | 100 uF 16 V radial 5x11 mm, 2.0 mm pitch [100u] |  |  |  |  |  |  |  |  |  |  | 2
UVR1C100MDD |  |  | Nichicon | 10 uF 16 V radial 5x11 mm, 2.0 mm pitch [10u] |  |  |  |  |  |  |  |  |  |  | 1
UVR1E2R2MDD |  |  | Nichicon | 2.2 uF 25 V radial 5x11 mm, 2.0 mm pitch [2.2u] |  |  |  |  |  |  |  |  |  |  | 2
UVR1E222MHD |  |  | Nichicon | 2200 uF 25 V radial 12.5x20 mm, 5 mm pitch [2200u] |  |  |  |  |  |  |  |  |  |  | 2
C315C221J1G5TA |  |  | KEMET | 220 pF C0G 100 V radial 2.5 mm [220p] |  |  |  |  |  |  |  |  |  |  | 2
UVR1C221MED |  |  | Nichicon | 220 uF 16 V radial 6.3x11 mm, 2.5 mm pitch [220u] |  |  |  |  |  |  |  |  |  |  | 3
C320C473K5R5TA |  |  | KEMET | 47 nF X7R 50 V radial 2.5 mm [47n] |  |  |  |  |  |  |  |  |  |  | 1
C315C470J1G5TA |  |  | KEMET | 47 pF C0G 100 V radial 2.5 mm [47p] |  |  |  |  |  |  |  |  |  |  | 2
UVR1C470MDD |  |  | Nichicon | 47 uF 16 V radial 5x11 mm, 2.0 mm pitch [47u] |  |  |  |  |  |  |  |  |  |  | 2
PRPC002SAAN-RC |  |  | Sullins | 1x2 pin header 2.54 mm [1x2 pin header 2.54 mm] |  |  |  |  |  |  |  |  |  |  | 2
PRPC003SAAN-RC |  |  | Sullins | 1x3 pin header 2.54 mm [1x3 pin header 2.54 mm] |  |  |  |  |  |  |  |  |  |  | 6
1715022 |  |  | Phoenix Contact | MKDS 1,5/ 2-5,08 screw terminal [2-pin screw terminal 5.08 mm] |  |  |  |  |  |  |  |  |  |  | 9
SJ1-3535NG |  |  | CUI Devices | 3.5 mm stereo jack, through-hole, with switch pins [3.5 mm TRS jack, CUI SJ1-3535NG] |  |  |  |  |  |  |  |  |  |  | 1
1N4007-E3/54 |  |  | Vishay | 1 A 1000 V rectifier DO-41 [1N4007] |  |  |  |  |  |  |  |  |  |  | 2
1N5401-E3/54 |  |  | Vishay | 3 A 100 V rectifier DO-201AD [1N5401] |  |  |  |  |  |  |  |  |  |  | 4
1N5232B-TAP |  |  | Vishay | 5.6 V 0.5 W zener DO-35 (fits the DO-41 pads) [5.6V] |  |  |  |  |  |  |  |  |  |  | 1
WP7104ID |  |  | Kingbright | 3 mm red LED [LED] |  |  |  |  |  |  |  |  |  |  | 1
WP7104ID |  |  | Kingbright | 3 mm red LED, tail current reference (RED only) [LED red] |  |  |  |  |  |  |  |  |  |  | 2
WP7104ID |  |  | Kingbright | 3 mm red LED (front panel, fit one of the two) [POWER LED] |  |  |  |  |  |  |  |  |  |  | 1
SB540-E3/54 |  |  | Vishay | 5 A 40 V Schottky DO-201AD [SB540] |  |  |  |  |  |  |  |  |  |  | 1
021801.6MXP |  |  | Littelfuse | 5x20 mm 1.6 A time-lag fuse [1.6A T 5x20] |  |  |  |  |  |  |  |  |  |  | 1
RXEF110 |  |  | Littelfuse | resettable fuse 1.1 A hold, 72 V, 5.1 mm pitch [PTC 1.1A] |  |  |  |  |  |  |  |  |  |  | 1
78F2R2K-RC |  |  | Bourns | 2.2 uH axial RF choke [2.2uH 1A] |  |  |  |  |  |  |  |  |  |  | 2
PTD902-2015K-A103 |  |  | Bourns | 9 mm dual-gang 10k audio taper, PC pins [10k log dual] |  |  |  |  |  |  |  |  |  |  | 1
3296W-1-202LF |  |  | Bourns | 2k 25-turn trimmer, PSU set point [2k] |  |  |  |  |  |  |  |  |  |  | 1
3296W-1-501LF |  |  | Bourns | 500 R 25-turn trimmer, bias set [500] |  |  |  |  |  |  |  |  |  |  | 2
KNP300JR-73-0R33 |  |  | Yageo | 0.33 R 5% 3 W wirewound, current sense [0.33 2W] |  |  |  |  |  |  |  |  |  |  | 1
KNP200JR-73-0R47 |  |  | Yageo | 0.47 R 5% 2 W wirewound, emitter resistors [0.47] |  |  |  |  |  |  |  |  |  |  | 4
MFR-25FBF52-1K2 |  |  | Yageo | 1.2k 1% 0.25 W [1.2k] |  |  |  |  |  |  |  |  |  |  | 2
MFR-25FBF52-10R |  |  | Yageo | 10 R 1% 0.25 W [10] |  |  |  |  |  |  |  |  |  |  | 4
MFR-25FBF52-100R |  |  | Yageo | 100 R 1% 0.25 W [100] |  |  |  |  |  |  |  |  |  |  | 4
MFR-25FBF52-10K |  |  | Yageo | 10k 1% 0.25 W [10k] |  |  |  |  |  |  |  |  |  |  | 1
MFR-25FBF52-120R |  |  | Yageo | 120 R 1% 0.25 W, headphone series [120] |  |  |  |  |  |  |  |  |  |  | 2
MFR-25FBF52-1K |  |  | Yageo | 1k 1% 0.25 W metal film [1k] |  |  |  |  |  |  |  |  |  |  | 6
MFR-25FBF52-2K2 |  |  | Yageo | 2.2k 1% 0.25 W [2.2k] |  |  |  |  |  |  |  |  |  |  | 1
MFR-25FBF52-22K |  |  | Yageo | 22k 1% 0.25 W [22k] |  |  |  |  |  |  |  |  |  |  | 2
MFR-25FBF52-270R |  |  | Yageo | 270 R 1% 0.25 W [270] |  |  |  |  |  |  |  |  |  |  | 4
MFR-25FBF52-4K7 |  |  | Yageo | 4.7k 1% 0.25 W [4.7k] |  |  |  |  |  |  |  |  |  |  | 3
MFR-25FBF52-47R |  |  | Yageo | 47 R 1% 0.25 W [47] |  |  |  |  |  |  |  |  |  |  | 2
MFR-25FBF52-47K |  |  | Yageo | 47k 1% 0.25 W metal film [47k] |  |  |  |  |  |  |  |  |  |  | 6
MFR-25FBF52-750R |  |  | Yageo | 750 R 1% 0.25 W, bias spreader [750] |  |  |  |  |  |  |  |  |  |  | 4
MFR-25FBF52-8K2 |  |  | Yageo | 8.2k 1% 0.25 W [8.2k] |  |  |  |  |  |  |  |  |  |  | 1
100DP1T1B1M2QEH |  |  | E-Switch | DPDT on-on miniature toggle, PC pins [SPK / HP] |  |  |  |  |  |  |  |  |  |  | 1
5001 |  |  | Keystone | PCB test point loop, white [test point loop (or a bare wire loop)] |  |  |  |  |  |  |  |  |  |  | 18
BC547BTA |  |  | onsemi | NPN TO-92 BC547B, hFE 200-450 [BC547] |  |  |  |  |  |  |  |  |  |  | 11
BC557BTA |  |  | onsemi | PNP TO-92 BC557B [BC557] |  |  |  |  |  |  |  |  |  |  | 6
BD139-16 |  |  | STMicroelectronics | NPN TO-126 1.5 A 80 V, hFE 100-250 [BD139] |  |  |  |  |  |  |  |  |  |  | 2
BD140-16 |  |  | STMicroelectronics | PNP TO-126 1.5 A 80 V, hFE 100-250 [BD140] |  |  |  |  |  |  |  |  |  |  | 2
TIP41C |  |  | STMicroelectronics | NPN TO-220 6 A 100 V pass transistor [TIP41C] |  |  |  |  |  |  |  |  |  |  | 1
3517 |  |  | Keystone | 5x20 mm fuse clip, PCB mount (2 per fuse) |  |  |  |  |  |  |  |  |  |  | 2
577202B00000G |  |  | Aavid | TO-220 clip-on heatsink for the PSU pass transistor |  |  |  |  |  |  |  |  |  |  | 1
574502B00000G |  |  | Aavid | TO-220/TO-126 clip-on heatsink for the four output transistors (optional, for 4 ohm speakers) |  |  |  |  |  |  |  |  |  |  | 4
