lahirunirmalx/discrete-stereo-amp/kicad/amp/amp.kicad_pcb

## KiCad design kicad/amp/amp.kicad_pcb (2026-11-10)

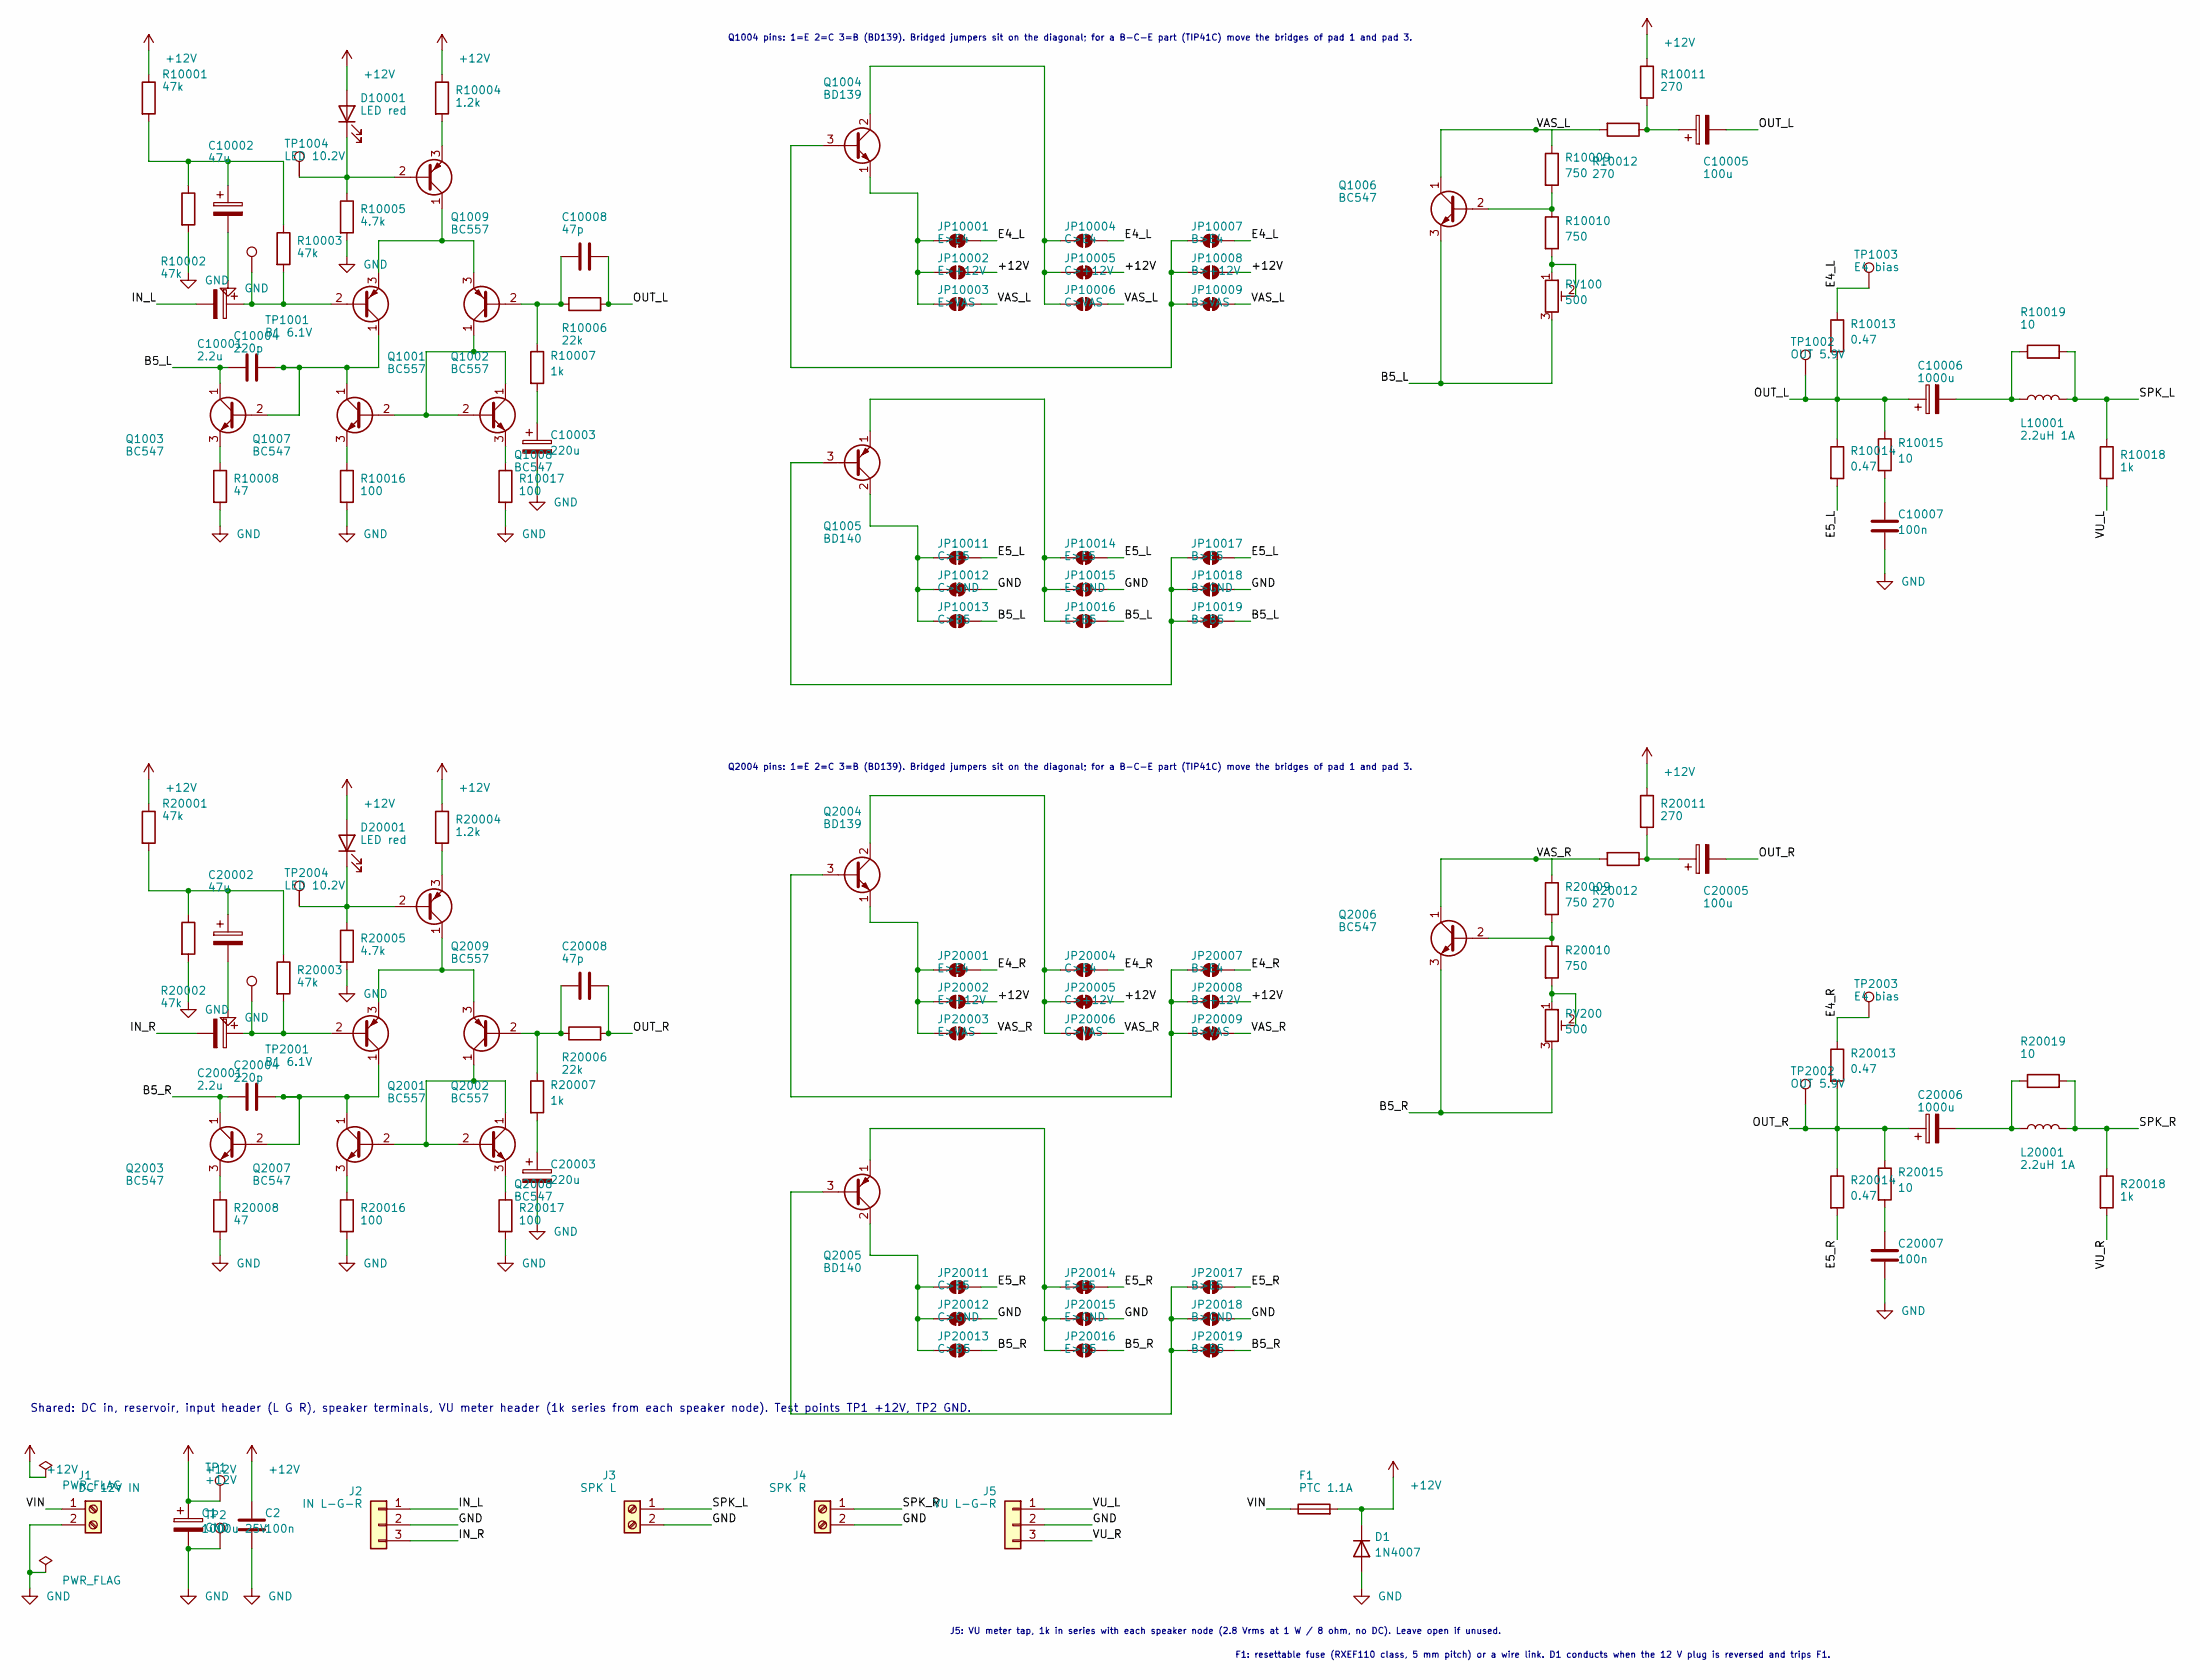
[picture p28: schematic amp.kicad_sch, Stereo class-AB amplifier (release 3) - mirror-loaded PNP i…]

Parts:
C1: 1000u 25V; CP_Radial_D10.0mm_P5.00mm
C2, C10007, C20007: 100n; C_P5_1206
C10001, C20001: 2.2u; CE_P2_1206
C10002, C20002: 47u; CE_P2_1206
C10003, C20003: 220u; CP_Radial_D6.3mm_P2.50mm
C10004, C20004: 220p; C_P5_1206
C10005, C20005: 100u; CP_Radial_D6.3mm_P2.50mm
C10006, C20006: 1000u; CP_Radial_D8.0mm_P3.50mm
C10008, C20008: 47p; C_P5_1206
D1: 1N4007; D_DO41_SMA
D10001, D20001: LED red; LED_D3_1206
F1: PTC 1.1A; C_P5_1206
J1: DC 12V IN; TerminalBlock_Phoenix_MKDS-1,5-2-5.08_1x02_P5.08mm_Horizont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
J2: IN L-G-R; PinHeader_1x03_P2.54mm_Vertical
J3: SPK L; TerminalBlock_Phoenix_MKDS-1,5-2-5.08_1x02_P5.08mm_Horizont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
J4: SPK R; TerminalBlock_Phoenix_MKDS-1,5-2-5.08_1x02_P5.08mm_Horizont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
J5: VU L-G-R; PinHeader_1x03_P2.54mm_Vertical
JP10001, JP20001: E>E4; SolderJumper-2_P1.3mm_Bridged_Pad1.0x1.5mm
JP10002, JP20002: E>+12V; SolderJumper-2_P1.3mm_Open_Pad1.0x1.5mm
JP10003, JP20003: E>VAS; SolderJumper-2_P1.3mm_Open_Pad1.0x1.5mm
JP10004, JP20004: C>E4; SolderJumper-2_P1.3mm_Open_Pad1.0x1.5mm
JP10005, JP20005: C>+12V; SolderJumper-2_P1.3mm_Bridged_Pad1.0x1.5mm
JP10006, JP20006: C>VAS; SolderJumper-2_P1.3mm_Open_Pad1.0x1.5mm
JP10007, JP20007: B>E4; SolderJumper-2_P1.3mm_Open_Pad1.0x1.5mm
JP10008, JP20008: B>+12V; SolderJumper-2_P1.3mm_Open_Pad1.0x1.5mm
JP10009, JP20009: B>VAS; SolderJumper-2_P1.3mm_Bridged_Pad1.0x1.5mm
JP10011, JP20011: C>E5; SolderJumper-2_P1.3mm_Open_Pad1.0x1.5mm
JP10012, JP20012: C>GND; SolderJumper-2_P1.3mm_Bridged_Pad1.0x1.5mm
JP10013, JP20013: C>B5; SolderJumper-2_P1.3mm_Open_Pad1.0x1.5mm
JP10014, JP20014: E>E5; SolderJumper-2_P1.3mm_Bridged_Pad1.0x1.5mm
JP10015, JP20015: E>GND; SolderJumper-2_P1.3mm_Open_Pad1.0x1.5mm
JP10016, JP20016: E>B5; SolderJumper-2_P1.3mm_Open_Pad1.0x1.5mm
JP10017, JP20017: B>E5; SolderJumper-2_P1.3mm_Open_Pad1.0x1.5mm
JP10018, JP20018: B>GND; SolderJumper-2_P1.3mm_Open_Pad1.0x1.5mm
JP10019, JP20019: B>B5; SolderJumper-2_P1.3mm_Bridged_Pad1.0x1.5mm
L10001, L20001: 2.2uH 1A; R_Axial_1206
Q1001, Q1002, Q1009, Q2001, Q2002, Q2009: BC557; TO92_SOT23
Q1003, Q1006, Q1007, Q1008, Q2003, Q2006, Q2007, Q2008: BC547; TO92_SOT23
Q1004, Q2004: BD139; TO-220-3_Vertical
Q1005, Q2005: BD140; TO-220-3_Vertical
R10001, R10002, R10003, R20001, R20002, R20003: 47k; R_Axial_1206
R10004, R20004: 1.2k; R_Axial_1206
R10005, R20005: 4.7k; R_Axial_1206
R10006, R20006: 22k; R_Axial_1206
R10007, R10018, R20007, R20018: 1k; R_Axial_1206
R10008, R20008: 47; R_Axial_1206
R10009, R10010, R20009, R20010: 750; R_Axial_1206
R10011, R10012, R20011, R20012: 270; R_Axial_1206
R10013, R10014, R20013, R20014: 0.47; R_Axial_DIN0414_L11.9mm_D4.5mm_P15.24mm_Horizontal
R10015, R10019, R20015, R20019: 10; R_Axial_1206
R10016, R10017, R20016, R20017: 100; R_Axial_1206
RV100, RV200: 500; Potentiometer_Bourns_3296W_Vertical
TP1: +12V; TestPoint_Loop_D2.50mm_Drill1.0mm
TP2: GND; TestPoint_Loop_D2.50mm_Drill1.0mm
TP1001, TP2001: B1 6.1V; TestPoint_Loop_D2.50mm_Drill1.0mm
TP1002, TP2002: OUT 5.9V; TestPoint_Loop_D2.50mm_Drill1.0mm
TP1003, TP2003: E4 bias; TestPoint_Loop_D2.50mm_Drill1.0mm
TP1004, TP2004: LED 10.2V; TestPoint_Loop_D2.50mm_Drill1.0mm

Connections:
+12V: C1.1, C2.1, C2.1S, D1.1 (K), D1.1S, D10001.2 (A), D10001.2S, D20001.2 (A), D20001.2S, F1.2, F1.2S, JP10002.2 (B), JP10005.2 (B), JP10008.2 (B), JP20002.2 (B), JP20005.2 (B), JP20008.2 (B), R10001.1, R10001.1S, R10004.1, R10004.1S, R10011.1, R10011.1S, R20001.1, R20001.1S, R20004.1, R20004.1S, R20011.1, R20011.1S, TP1.1
/B5_L: C10004.1, C10004.1S, JP10013.2 (B), JP10016.2 (B), JP10019.2 (B), Q1003.1 (C), Q1003.1S, Q1006.3 (E), Q1006.3S, RV100.3
/B5_R: C20004.1, C20004.1S, JP20013.2 (B), JP20016.2 (B), JP20019.2 (B), Q2003.1 (C), Q2003.1S, Q2006.3 (E), Q2006.3S, RV200.3
/E4_L: JP10001.2 (B), JP10004.2 (B), JP10007.2 (B), R10013.1, TP1003.1
/E4_R: JP20001.2 (B), JP20004.2 (B), JP20007.2 (B), R20013.1, TP2003.1
/E5_L: JP10011.2 (B), JP10014.2 (B), JP10017.2 (B), R10014.2
/E5_R: JP20011.2 (B), JP20014.2 (B), JP20017.2 (B), R20014.2
/IN_L: C10001.2, C10001.2S, J2.1
/IN_R: C20001.2, C20001.2S, J2.3
/OUT_L: C10005.2, C10006.1, C10008.2, C10008.2S, R10006.2, R10006.2S, R10013.2, R10014.1, R10015.1, R10015.1S, TP1002.1
/OUT_R: C20005.2, C20006.1, C20008.2, C20008.2S, R20006.2, R20006.2S, R20013.2, R20014.1, R20015.1, R20015.1S, TP2002.1
/SPK_L: J3.1, L10001.2, L10001.2S, R10018.1, R10018.1S, R10019.2, R10019.2S
/SPK_R: J4.1, L20001.2, L20001.2S, R20018.1, R20018.1S, R20019.2, R20019.2S
/VAS_L: JP10003.2 (B), JP10006.2 (B), JP10009.2 (B), Q1006.1 (C), Q1006.1S, R10009.1, R10009.1S, R10012.2, R10012.2S
/VAS_R: JP20003.2 (B), JP20006.2 (B), JP20009.2 (B), Q2006.1 (C), Q2006.1S, R20009.1, R20009.1S, R20012.2, R20012.2S
/VIN: F1.1, F1.1S, J1.1
/VU_L: J5.1, R10018.2, R10018.2S
/VU_R: J5.3, R20018.2, R20018.2S
GND: C1.2, C2.2, C2.2S, C10002.2, C10002.2S, C10003.2, C10007.2, C10007.2S, C20002.2, C20002.2S, C20003.2, C20007.2, C20007.2S, D1.2 (A), D1.2S, J1.2, J2.2, J3.2, J4.2, J5.2, JP10012.2 (B), JP10015.2 (B), JP10018.2 (B), JP20012.2 (B), JP20015.2 (B), JP20018.2 (B), R10002.2, R10002.2S, R10005.2, R10005.2S, R10008.2, R10008.2S, R10016.2, R10016.2S, R10017.2, R10017.2S, R20002.2, R20002.2S, R20005.2, R20005.2S, R20008.2, R20008.2S, R20016.2, R20016.2S, R20017.2, R20017.2S, TP2.1
unnamed: C10002.1, C10002.1S, R10001.2, R10001.2S, R10002.1, R10002.1S, R10003.1, R10003.1S
unnamed: C10003.1, R10007.2, R10007.2S
unnamed: C10005.1, R10011.2, R10011.2S, R10012.1, R10012.1S
unnamed: C10006.2, L10001.1, L10001.1S, R10019.1, R10019.1S
unnamed: C10007.1, C10007.1S, R10015.2, R10015.2S
unnamed: C20002.1, C20002.1S, R20001.2, R20001.2S, R20002.1, R20002.1S, R20003.1, R20003.1S
unnamed: C20003.1, R20007.2, R20007.2S
unnamed: C20005.1, R20011.2, R20011.2S, R20012.1, R20012.1S
unnamed: C20006.2, L20001.1, L20001.1S, R20019.1, R20019.1S
unnamed: C20007.1, C20007.1S, R20015.2, R20015.2S
unnamed: D10001.1 (K), D10001.1S, Q1009.2 (B), Q1009.2S, R10005.1, R10005.1S, TP1004.1
unnamed: D20001.1 (K), D20001.1S, Q2009.2 (B), Q2009.2S, R20005.1, R20005.1S, TP2004.1
unnamed: JP10001.1 (A), JP10002.1 (A), JP10003.1 (A), Q1004.1 (E)
unnamed: JP10004.1 (A), JP10005.1 (A), JP10006.1 (A), Q1004.2 (C)
unnamed: JP10007.1 (A), JP10008.1 (A), JP10009.1 (A), Q1004.3 (B)
unnamed: JP10011.1 (A), JP10012.1 (A), JP10013.1 (A), Q1005.2 (C)
unnamed: JP10014.1 (A), JP10015.1 (A), JP10016.1 (A), Q1005.1 (E)
unnamed: JP10017.1 (A), JP10018.1 (A), JP10019.1 (A), Q1005.3 (B)
unnamed: JP20001.1 (A), JP20002.1 (A), JP20003.1 (A), Q2004.1 (E)
unnamed: JP20004.1 (A), JP20005.1 (A), JP20006.1 (A), Q2004.2 (C)
unnamed: JP20007.1 (A), JP20008.1 (A), JP20009.1 (A), Q2004.3 (B)
unnamed: JP20011.1 (A), JP20012.1 (A), JP20013.1 (A), Q2005.2 (C)
unnamed: JP20014.1 (A), JP20015.1 (A), JP20016.1 (A), Q2005.1 (E)
unnamed: JP20017.1 (A), JP20018.1 (A), JP20019.1 (A), Q2005.3 (B)
unnamed: C10001.1, C10001.1S, Q1001.2 (B), Q1001.2S, R10003.2, R10003.2S, TP1001.1
unnamed: C10004.2, C10004.2S, Q1001.1 (C), Q1001.1S, Q1003.2 (B), Q1003.2S, Q1007.1 (C), Q1007.1S
unnamed: Q1001.3 (E), Q1001.3S, Q1002.3 (E), Q1002.3S, Q1009.1 (C), Q1009.1S
unnamed: C10008.1, C10008.1S, Q1002.2 (B), Q1002.2S, R10006.1, R10006.1S, R10007.1, R10007.1S
unnamed: Q1002.1 (C), Q1002.1S, Q1007.2 (B), Q1007.2S, Q1008.1 (C), Q1008.1S, Q1008.2 (B), Q1008.2S
unnamed: Q1003.3 (E), Q1003.3S, R10008.1, R10008.1S
unnamed: Q1006.2 (B), Q1006.2S, R10009.2, R10009.2S, R10010.1, R10010.1S
unnamed: Q1007.3 (E), Q1007.3S, R10016.1, R10016.1S
unnamed: Q1008.3 (E), Q1008.3S, R10017.1, R10017.1S
unnamed: Q1009.3 (E), Q1009.3S, R10004.2, R10004.2S
unnamed: C20001.1, C20001.1S, Q2001.2 (B), Q2001.2S, R20003.2, R20003.2S, TP2001.1
unnamed: C20004.2, C20004.2S, Q2001.1 (C), Q2001.1S, Q2003.2 (B), Q2003.2S, Q2007.1 (C), Q2007.1S
unnamed: Q2001.3 (E), Q2001.3S, Q2002.3 (E), Q2002.3S, Q2009.1 (C), Q2009.1S
unnamed: C20008.1, C20008.1S, Q2002.2 (B), Q2002.2S, R20006.1, R20006.1S, R20007.1, R20007.1S
unnamed: Q2002.1 (C), Q2002.1S, Q2007.2 (B), Q2007.2S, Q2008.1 (C), Q2008.1S, Q2008.2 (B), Q2008.2S
unnamed: Q2003.3 (E), Q2003.3S, R20008.1, R20008.1S
unnamed: Q2006.2 (B), Q2006.2S, R20009.2, R20009.2S, R20010.1, R20010.1S
unnamed: Q2007.3 (E), Q2007.3S, R20016.1, R20016.1S
unnamed: Q2008.3 (E), Q2008.3S, R20017.1, R20017.1S
unnamed: Q2009.3 (E), Q2009.3S, R20004.2, R20004.2S
unnamed: R10010.2, R10010.2S, RV100.1, RV100.2
unnamed: R20010.2, R20010.2S, RV200.1, RV200.2

Notes on the sheet:
Q1004 pins: 1=E 2=C 3=B (BD139). Bridged jumpers sit on the diagonal; for a B-C-E part (TIP41C) move the bridges of pad 1 and pad 3.
Q2004 pins: 1=E 2=C 3=B (BD139). Bridged jumpers sit on the diagonal; for a B-C-E part (TIP41C) move the bridges of pad 1 and pad 3.
Shared: DC in, reservoir, input header (L G R), speaker terminals, VU meter header (1k series from each speaker node). Test points TP1 +12V, TP2 GND.
F1: resettable fuse (RXEF110 class, 5 mm pitch) or a wire link. D1 conducts when the 12 V plug is reversed and trips F1.
J5: VU meter tap, 1k in series with each speaker node (2.8 Vrms at 1 W / 8 ohm, no DC). Leave open if unused.

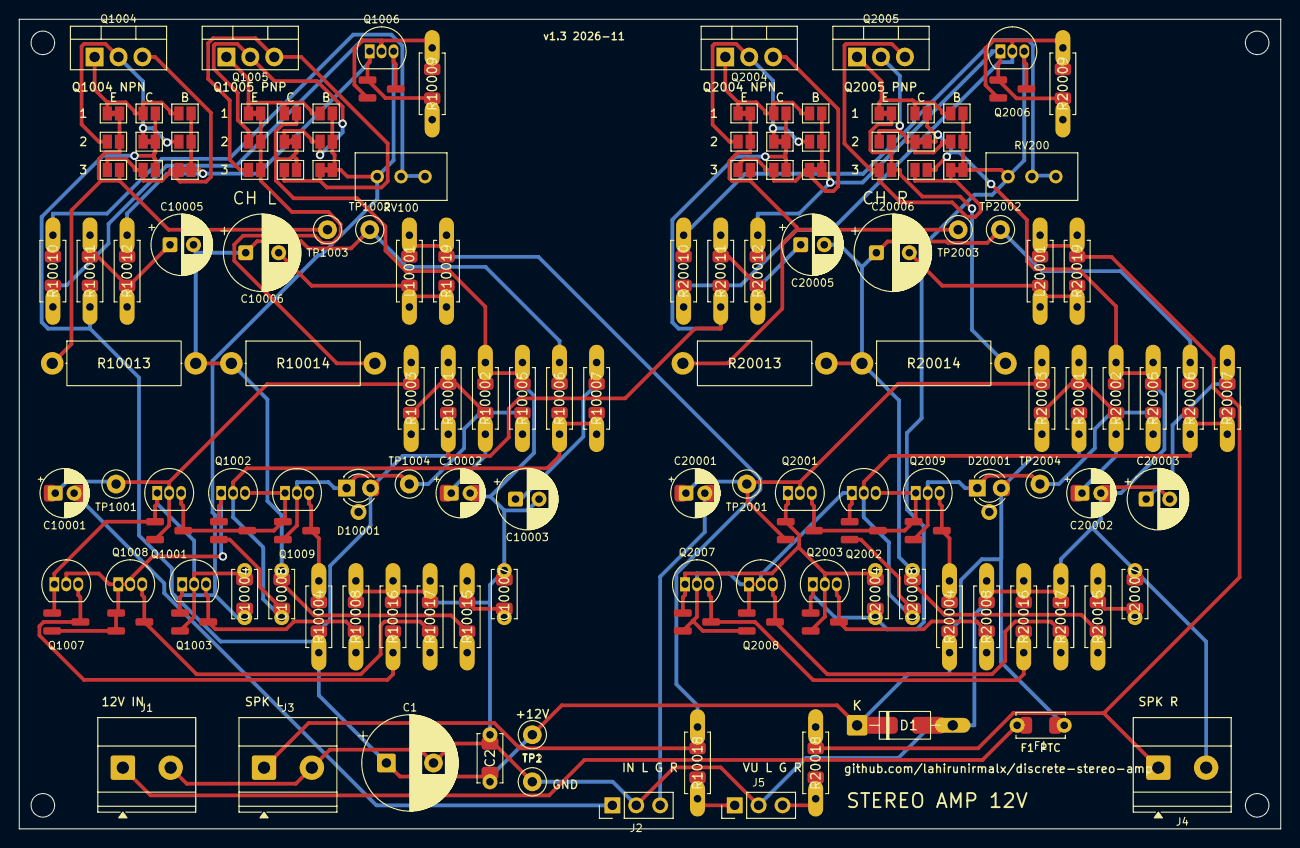
[picture p29: board amp.kicad_pcb from above]

Board: 2 copper layers, 134.0 x 86.0 mm, 137 parts (0 on the bottom side), 65 nets.

Other parts of the board:
H1, H2, H3, H4: M2.5; Hole_2.5mm
