lahirunirmalx/discrete-stereo-amp/kicad/vol/vol.kicad_pcb

## KiCad design kicad/vol/vol.kicad_pcb (2026-11-10)

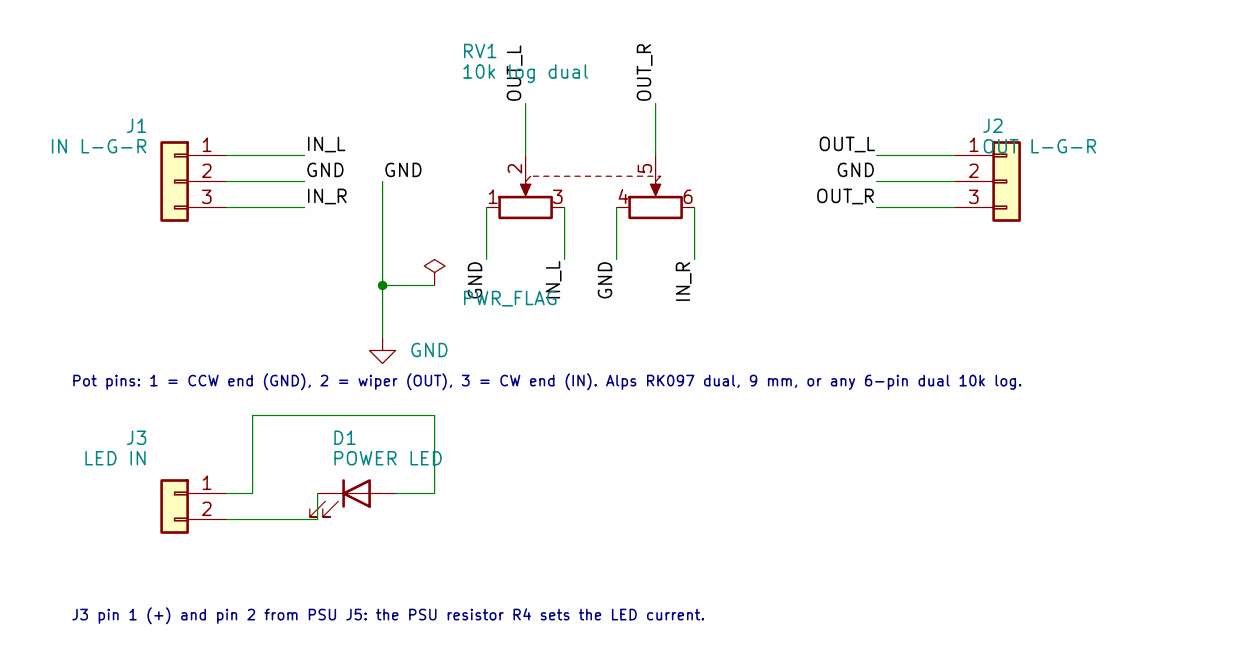
[picture p30: schematic vol.kicad_sch, Stereo volume control - dual 10k log pot]

Parts:
D1: POWER LED; LED_D3_1206
J1: IN L-G-R; PinHeader_1x03_P2.54mm_Vertical
J2: OUT L-G-R; PinHeader_1x03_P2.54mm_Vertical
J3: LED IN; PinHeader_1x02_P2.54mm_Vertical
RV1: 10k log dual; Potentiometer_Alps_RK097_Dual_Horizontal

Connections:
/IN_L: J1.1, RV1.3
/IN_R: J1.3, RV1.6
/OUT_L: J2.1, RV1.2
/OUT_R: J2.3, RV1.5
GND: J1.2, J2.2, RV1.1, RV1.4
unnamed: D1.2 (A), D1.2S, J3.1
unnamed: D1.1 (K), D1.1S, J3.2

Notes on the sheet:
J3 pin 1 (+) and pin 2 from PSU J5: the PSU resistor R4 sets the LED current.
Pot pins: 1 = CCW end (GND), 2 = wiper (OUT), 3 = CW end (IN). Alps RK097 dual, 9 mm, or any 6-pin dual 10k log.

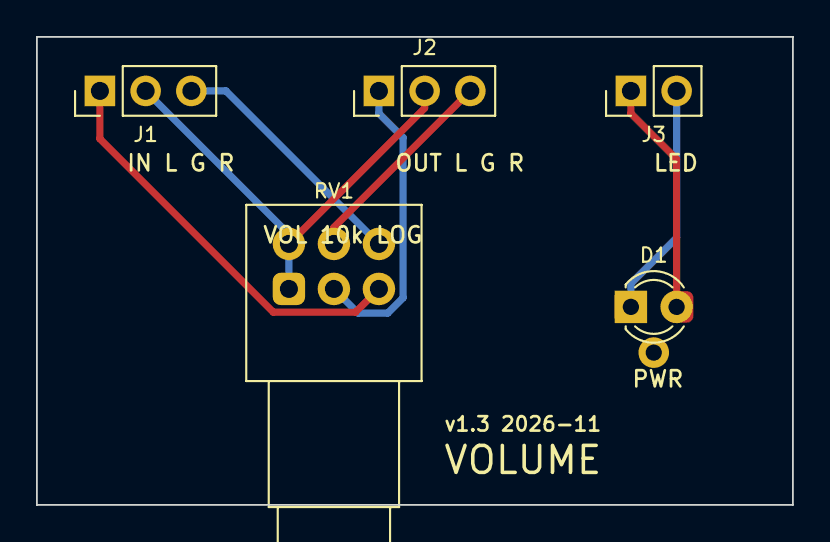
[picture p31: board vol.kicad_pcb from above]

Board: 2 copper layers, 42.0 x 26.0 mm, 5 parts (0 on the bottom side), 7 nets.
