lahirunirmalx/discrete-stereo-amp/kicad/psu/psu.kicad_pcb

## KiCad design kicad/psu/psu.kicad_pcb (2026-11-10)

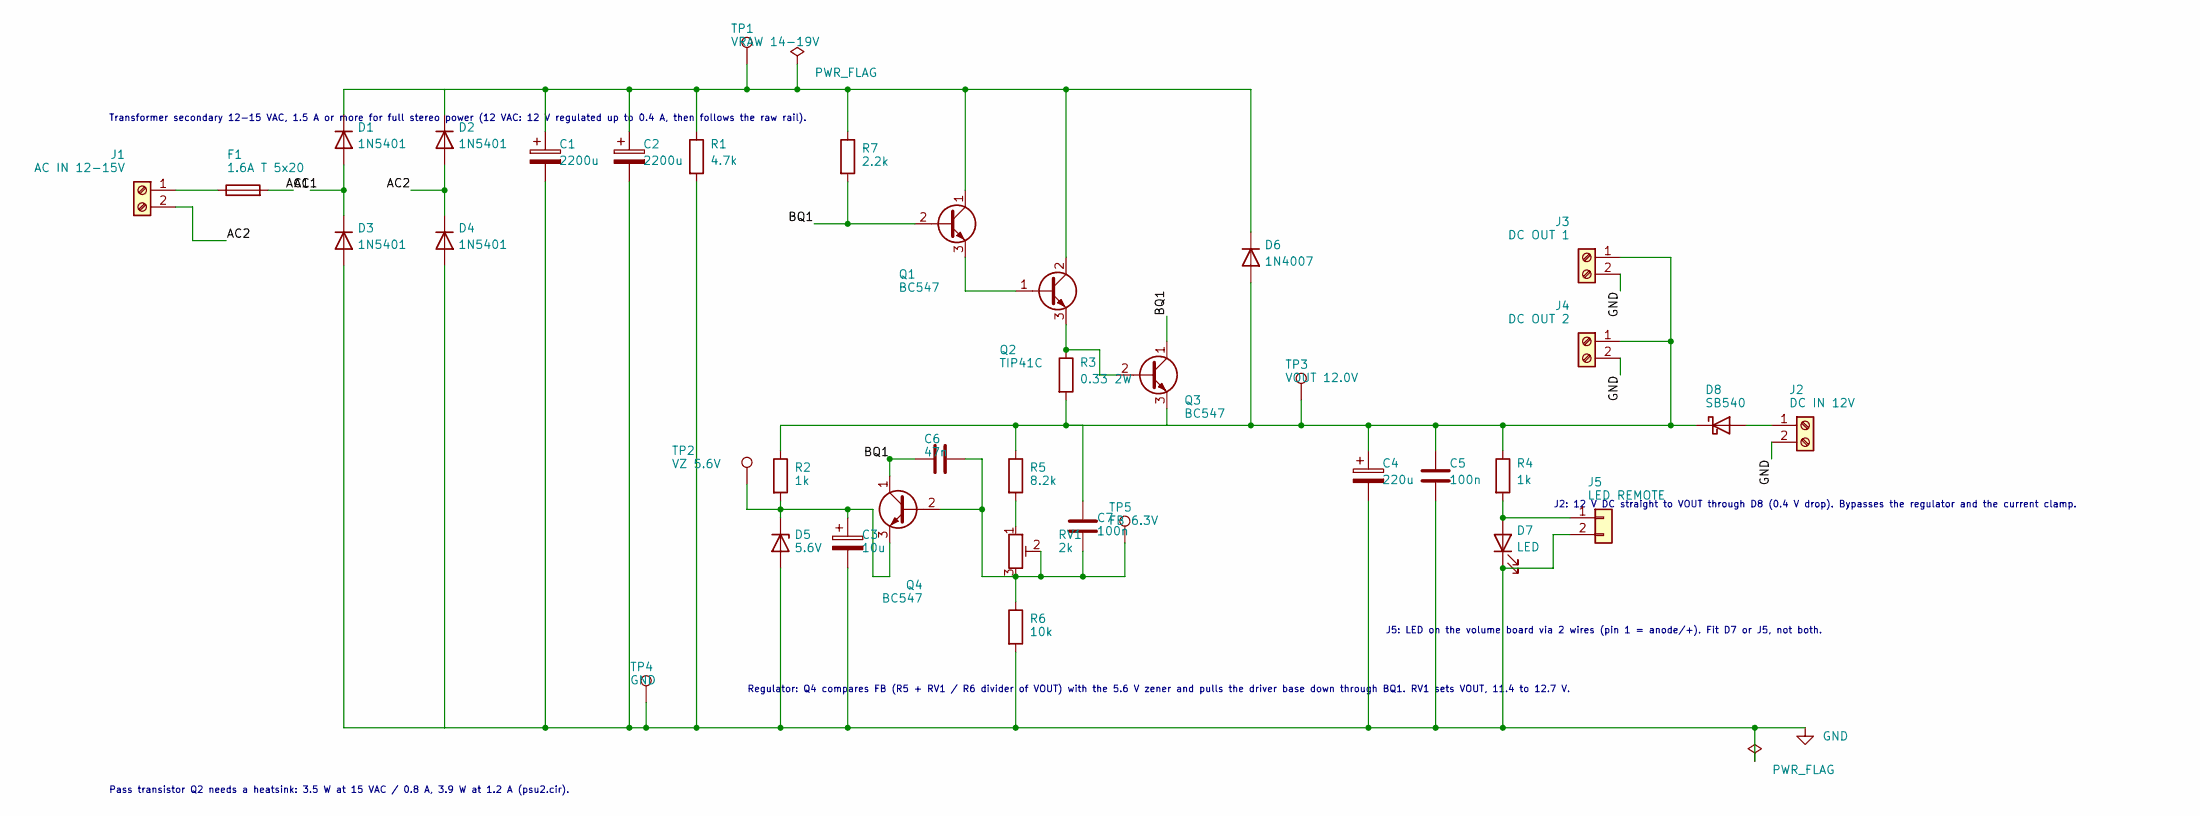
[picture p32: schematic psu.kicad_sch, Discrete 12 V power supply (release 2) - bridge, closed-loo…]

Parts:
C1, C2: 2200u; CP_Radial_D13.0mm_P5.00mm
C3: 10u; CE_P2_1206
C4: 220u; CP_Radial_D6.3mm_P2.50mm
C5, C7: 100n; C_P5_1206
C6: 47n; C_P5_1206
D1, D2, D3, D4: 1N5401; D_DO201_SMA
D5: 5.6V; D_DO41_SMA
D6: 1N4007; D_DO41_SMA
D7: LED; LED_D3_1206
D8: SB540; D_DO201_SMA
F1: 1.6A T 5x20; Fuseholder_Clip-5x20mm_Littelfuse_100_Inline_P20.50x4.60mm_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
J1: AC IN 12-15V; TerminalBlock_Phoenix_MKDS-1,5-2-5.08_1x02_P5.08mm_Horizont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
J2: DC IN 12V; TerminalBlock_Phoenix_MKDS-1,5-2-5.08_1x02_P5.08mm_Horizont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
J3: DC OUT 1; TerminalBlock_Phoenix_MKDS-1,5-2-5.08_1x02_P5.08mm_Horizont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
J4: DC OUT 2; TerminalBlock_Phoenix_MKDS-1,5-2-5.08_1x02_P5.08mm_Horizont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
J5: LED REMOTE; PinHeader_1x02_P2.54mm_Vertical
Q1, Q3, Q4: BC547; TO92_SOT23
Q2: TIP41C; TO-220-3_Vertical
R1: 4.7k; R_Axial_1206
R2, R4: 1k; R_Axial_1206
R3: 0.33 2W; R_Axial_DIN0414_L11.9mm_D4.5mm_P15.24mm_Horizontal
R5: 8.2k; R_Axial_1206
R6: 10k; R_Axial_1206
R7: 2.2k; R_Axial_1206
RV1: 2k; Potentiometer_Bourns_3296W_Vertical
TP1: VRAW 14-19V; TestPoint_Loop_D2.50mm_Drill1.0mm
TP2: VZ 5.6V; TestPoint_Loop_D2.50mm_Drill1.0mm
TP3: VOUT 12.0V; TestPoint_Loop_D2.50mm_Drill1.0mm
TP4: GND; TestPoint_Loop_D2.50mm_Drill1.0mm
TP5: FB 6.3V; TestPoint_Loop_D2.50mm_Drill1.0mm

Connections:
/AC1: D1.2 (A), D1.2S, D3.1 (K), D3.1S, F1.2
/AC2: D2.2 (A), D2.2S, D4.1 (K), D4.1S, J1.2
/BQ1: C6.1, C6.1S, Q1.2 (B), Q1.2S, Q3.1 (C), Q3.1S, Q4.1 (C), Q4.1S, R7.2, R7.2S
GND: C1.2, C2.2, C3.2, C3.2S, C4.2, C5.2, C5.2S, D3.2 (A), D3.2S, D4.2 (A), D4.2S, D5.2 (A), D5.2S, D7.1 (K), D7.1S, J2.2, J3.2, J4.2, J5.2, R1.2, R1.2S, R6.2, R6.2S, TP4.1
unnamed: C1.1, C2.1, D1.1 (K), D1.1S, D2.1 (K), D2.1S, D6.1 (K), D6.1S, Q1.1 (C), Q1.1S, Q2.2 (C), R1.1, R1.1S, R7.1, R7.1S, TP1.1
unnamed: C3.1, C3.1S, D5.1 (K), D5.1S, Q4.3 (E), Q4.3S, R2.2, R2.2S, TP2.1
unnamed: C4.1, C5.1, C5.1S, C7.1, C7.1S, D6.2 (A), D6.2S, D8.1 (K), D8.1S, J3.1, J4.1, Q3.3 (E), Q3.3S, R2.1, R2.1S, R3.2, R4.1, R4.1S, R5.1, R5.1S, TP3.1
unnamed: D7.2 (A), D7.2S, J5.1, R4.2, R4.2S
unnamed: D8.2 (A), D8.2S, J2.1
unnamed: F1.1, J1.1
unnamed: Q1.3 (E), Q1.3S, Q2.1 (B)
unnamed: Q2.3 (E), Q3.2 (B), Q3.2S, R3.1
unnamed: C6.2, C6.2S, C7.2, C7.2S, Q4.2 (B), Q4.2S, R6.1, R6.1S, RV1.2, RV1.3, TP5.1
unnamed: R5.2, R5.2S, RV1.1

Notes on the sheet:
Transformer secondary 12-15 VAC, 1.5 A or more for full stereo power (12 VAC: 12 V regulated up to 0.4 A, then follows the raw rail).
Regulator: Q4 compares FB (R5 + RV1 / R6 divider of VOUT) with the 5.6 V zener and pulls the driver base down through BQ1. RV1 sets VOUT, 11.4 to 12.7 V.
J5: LED on the volume board via 2 wires (pin 1 = anode/+). Fit D7 or J5, not both.
J2: 12 V DC straight to VOUT through D8 (0.4 V drop). Bypasses the regulator and the current clamp.
Pass transistor Q2 needs a heatsink: 3.5 W at 15 VAC / 0.8 A, 3.9 W at 1.2 A (psu2.cir).

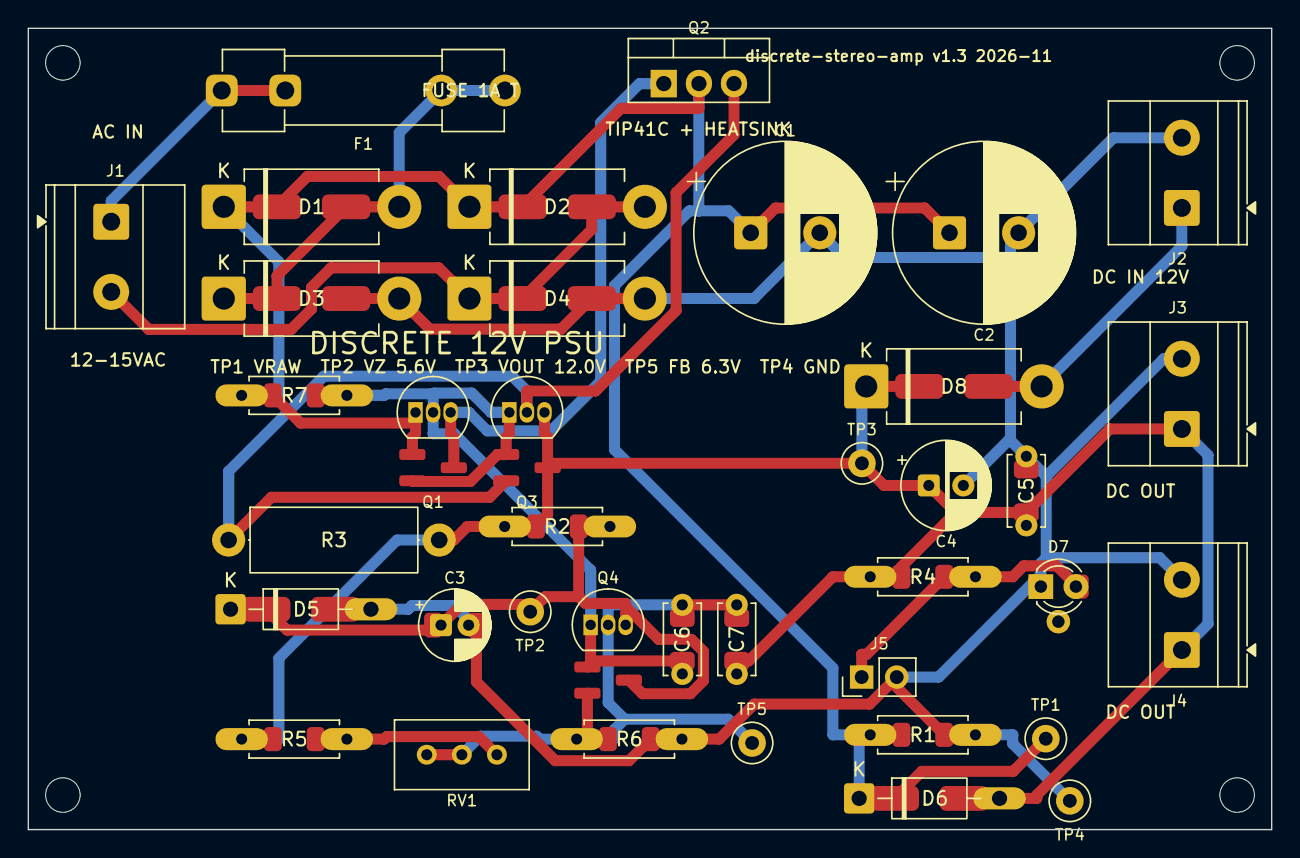
[picture p33: board psu.kicad_pcb from above]

Board: 2 copper layers, 90.0 x 58.0 mm, 42 parts (0 on the bottom side), 14 nets.

Other parts of the board:
H1, H2, H3, H4: M2.5; Hole_2.5mm
