lahirunirmalx/discrete-stereo-amp/kicad/hp/hp.kicad_pcb

## KiCad design kicad/hp/hp.kicad_pcb (2026-11-10)

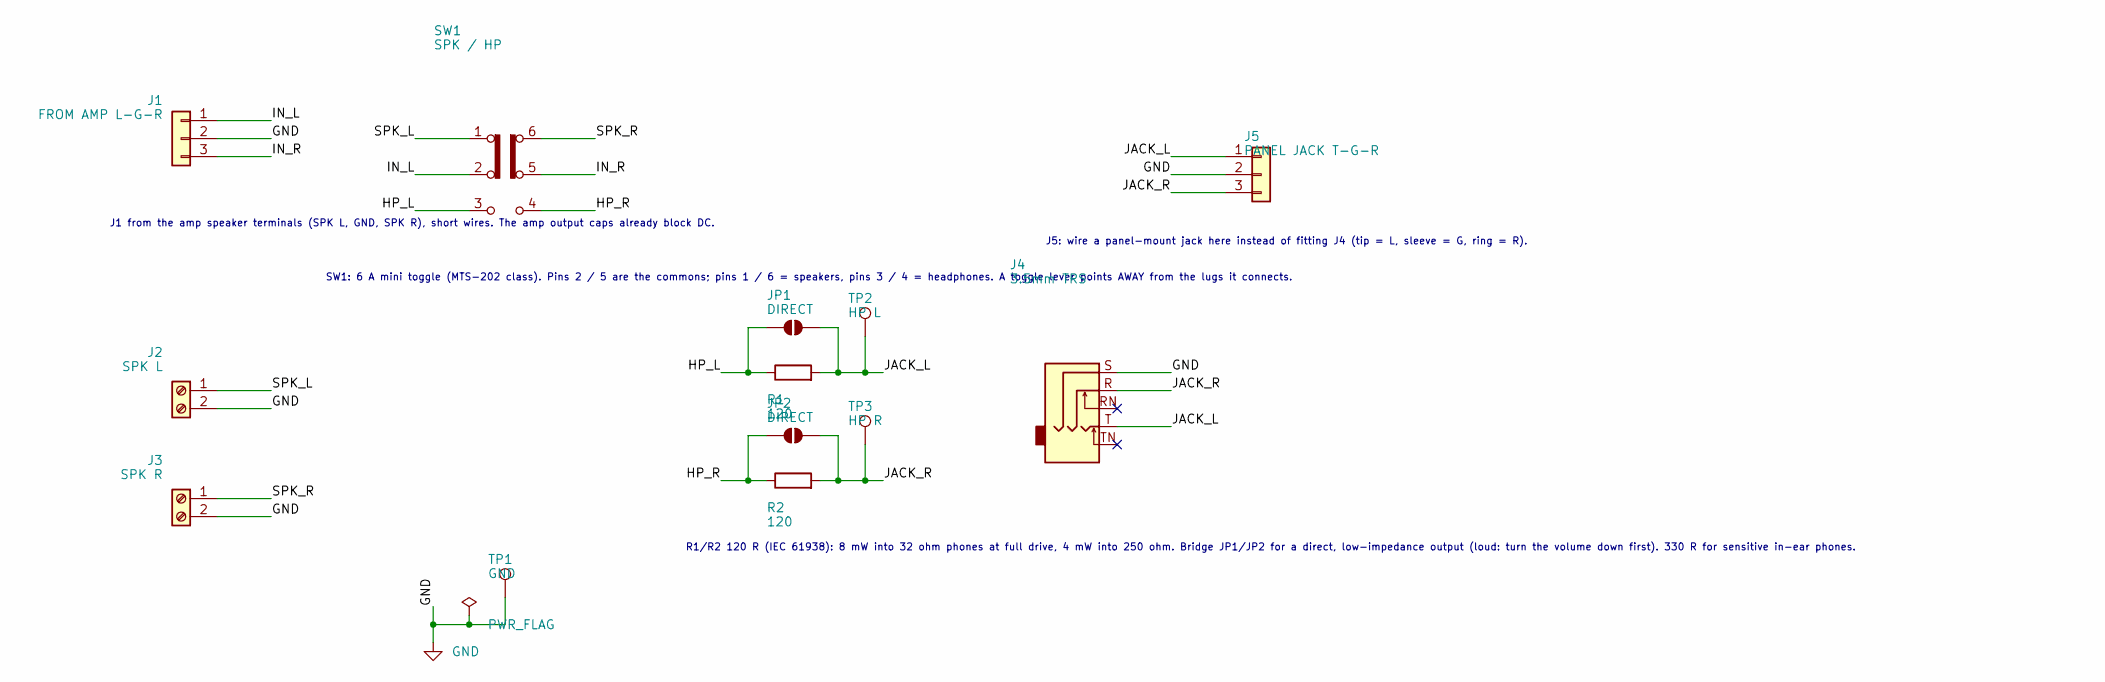
[picture p34: schematic hp.kicad_sch, Headphone board (release 2) - speaker / headphone switch, s…]

Parts:
J1: FROM AMP L-G-R; PinHeader_1x03_P2.54mm_Vertical
J2: SPK L; TerminalBlock_Phoenix_MKDS-1,5-2-5.08_1x02_P5.08mm_Horizont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
J3: SPK R; TerminalBlock_Phoenix_MKDS-1,5-2-5.08_1x02_P5.08mm_Horizont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
J4: 3.5mm TRS; Jack_3.5mm_CUI_SJ1-3535NG_Horizontal
J5: PANEL JACK T-G-R; PinHeader_1x03_P2.54mm_Vertical
JP1, JP2: DIRECT; SolderJumper-2_P1.3mm_Open_Pad1.0x1.5mm
R1, R2: 120; R_Axial_1206
SW1: SPK / HP; SW_DPDT_MTS202
TP1: GND; TestPoint_Loop_D2.50mm_Drill1.0mm
TP2: HP L; TestPoint_Loop_D2.50mm_Drill1.0mm
TP3: HP R; TestPoint_Loop_D2.50mm_Drill1.0mm

Connections:
/HP_L: JP1.1 (A), R1.1, R1.1S, SW1.3 (C)
/HP_R: JP2.1 (A), R2.1, R2.1S, SW1.4 (A)
/IN_L: J1.1, SW1.2 (B)
/IN_R: J1.3, SW1.5 (B)
/JACK_L: J4.T, J5.1, JP1.2 (B), R1.2, R1.2S, TP2.1
/JACK_R: J4.R, J5.3, JP2.2 (B), R2.2, R2.2S, TP3.1
/SPK_L: J2.1, SW1.1 (A)
/SPK_R: J3.1, SW1.6 (C)
GND: J1.2, J2.2, J3.2, J4.S, J5.2, TP1.1

Notes on the sheet:
J1 from the amp speaker terminals (SPK L, GND, SPK R), short wires. The amp output caps already block DC.
SW1: 6 A mini toggle (MTS-202 class). Pins 2 / 5 are the commons; pins 1 / 6 = speakers, pins 3 / 4 = headphones. A toggle lever points AWAY from the lugs it connects.
R1/R2 120 R (IEC 61938): 8 mW into 32 ohm phones at full drive, 4 mW into 250 ohm. Bridge JP1/JP2 for a direct, low-impedance output (loud: turn the volume down first). 330 R for sensitive in-ear phones.
J5: wire a panel-mount jack here instead of fitting J4 (tip = L, sleeve = G, ring = R).

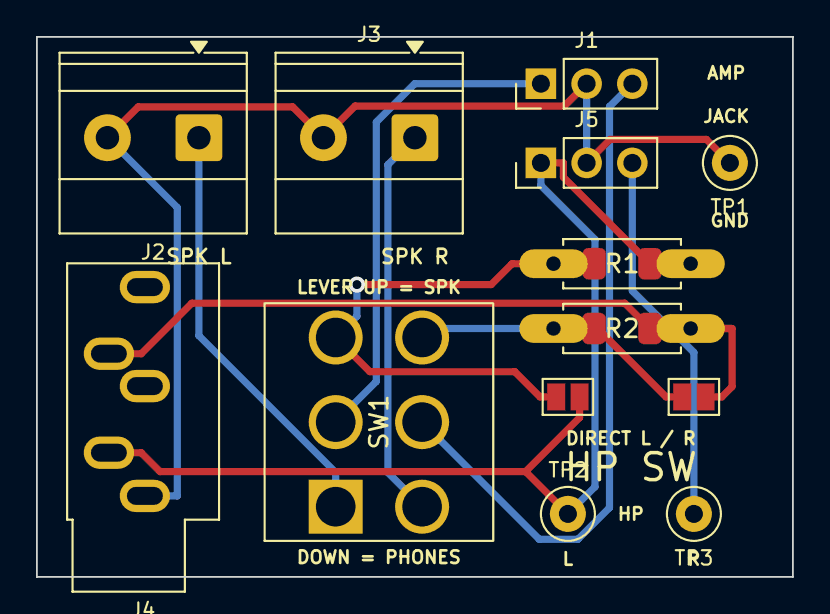
[picture p35: board hp.kicad_pcb from above]

Board: 2 copper layers, 42.0 x 30.0 mm, 13 parts (0 on the bottom side), 9 nets.
