lahirunirmalx/discrete-stereo-amp/(commit log)

2026-10-21 Release 1: stereo class-AB amp, discrete 12 V PSU, volume board
    Simulated in ngspice, generated KiCad 9 boards (2-layer panel DRC clean, single-sided
    variants), BOMs, documents, 3D renders. Licensed CC BY-NC-SA 4.0.
    [amp.kicad_pcb, amp.kicad_sch, amp_1layer.kicad_pcb, bom_all.csv, bom_amp.csv, bom_mouser.csv, bom_psu.csv, bom_shopping.csv]
2026-10-21 Rotate screw terminals to face the board edge, add 3D views, schematics and layouts to the README, CircuitJS links in the review
    Amp board is 100 x 85 mm after the hybrid-footprint courtyards grew; input header moved to open space
    on the bottom edge so freerouting completes. Panel 134 x 137 mm, DRC clean.
    [amp.kicad_pcb, amp_1layer.kicad_pcb, psu.kicad_pcb, psu_1layer.kicad_pcb, stereo-panel.kicad_pcb]
2026-10-21 Square 144 x 144 mm panel with rails; amp widened to 134 x 71 mm so PSU plus volume board match its width; readable silkscreen
    References sit inside resistor, diode and ceramic outlines along the body axis, larger text; electrolytic,
    transistor and test-point labels stay beside the part. Hybrid footprints built from the library parts keep
    polarity marks. All 2-layer boards, the panel and the single-sided PSU and volume boards are DRC clean.
    [amp.kicad_pcb, amp_1layer.kicad_pcb, psu.kicad_pcb, psu_1layer.kicad_pcb, stereo-panel.kicad_pcb, vol.kicad_pcb, vol_1layer.kicad_pcb]
2026-10-21 Repository URL and revision on every silkscreen and on the panel rails
    [amp.kicad_pcb, amp_1layer.kicad_pcb, psu.kicad_pcb, psu_1layer.kicad_pcb, stereo-panel.kicad_pcb, vol.kicad_pcb, vol_1layer.kicad_pcb]
2026-10-21 Panel rebuilt from the stamped boards; rail texts generated by make_panel.py
    [stereo-panel.kicad_pcb]
2026-10-21 Release 1.1: square panel, rotated terminals, readable silkscreen, URL and revision stamps
    [amp.kicad_pcb, amp_1layer.kicad_pcb, psu.kicad_pcb, psu_1layer.kicad_pcb, stereo-panel.kicad_pcb, vol.kicad_pcb, vol_1layer.kicad_pcb]
2026-10-21 Logo and social banner (analog knob / scope-trace style), banner at the top of the README
2026-10-22 Preamp study: sensitivity, noise and gain vs pot position of the channel; two candidate stages; verdict
2026-10-22 Per-board 2-layer gerber zips in the release package; ordering options in the guide
2026-10-22 Compact 100 x 85 mm amp layout as a selectable second variant; modular build paths and the three design rules documented; per-board gerbers include both amps
    [amp.kicad_pcb, amp_compact.kicad_pcb, stereo-panel.kicad_pcb]
2026-10-22 Compact amp: title between the channels, revision at the bottom edge, URL on the back silkscreen; release copies the compact board
    [amp_compact.kicad_pcb]
2026-10-22 Compact amp title moved clear of the trimmer label
    [amp_compact.kicad_pcb]
2026-10-22 Release 1.2: mirror-loaded front end, closed-loop PSU, VU tap, headphone board
    - Amp: PNP input pair with NPN current-mirror load, LED-referenced current-source tail,
    NPN VAS with bootstrapped load from +12V, 220p Miller + 47p lead cap (THD 0.004% at 26 mW/8R,
    0.019% at 0.29 W; was 0.03 / 0.2). 1k VU meter tap per channel to header J5.
    - PSU: BC547 error amplifier, 5.6 V zener fed from VOUT, 8.2k + 2k trimmer / 10k divider,
    2.2k drive, 47n/100n compensation. 12.0 V set point, 0.14 V dip on a 1 A step.
    - New headphone board (DPDT switch, 120R series, DIRECT jumpers, 3.5 mm jack, panel-jack header).
    - Boards: amp 134x85 / compact 100x98, PSU 90x58, hp 42x30; panel 155x155 with four board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
    [amp.kicad_pcb, amp.kicad_sch, amp_1layer.kicad_pcb, amp_compact.kicad_pcb, bom_all.csv, bom_amp.csv, bom_hp.csv, bom_mouser.csv]
2026-10-22 Headphone jack sleeve pad was left without its GND net
    pcbgen stripped the SMD-twin suffix from every pad number ending in S, which turned the jack's
    sleeve pad "S" into an empty key. Exact pad numbers are matched first now. Headphone boards,
    panel, images and the release zip rebuilt; single-layer headphone board 3 wire links, clean.
    [hp.kicad_pcb, hp_1layer.kicad_pcb, stereo-panel.kicad_pcb]
2026-10-22 Note for the next PCB revision: LED positions need the hybrid footprint
2026-11-10 Revision 1.3: second design review fixes
    - Output inductor 2.2 uH + 10 R per channel (phase margin 65 deg or more up to 2.2 uF; was 20 deg at 47-100 nF).
    - Bias trimmer in the base-emitter leg (750 / 750 + 500R): 2 to 70 mA, open wiper = minimum.
    - Amp 12 V input: resettable fuse F1 + reverse diode D1; rail capacitor C1 25 V.
    - PSU fuse 1.6 A slow-blow, sized for the RMS secondary current.
    - Headphone switch: 6 A miniature toggle footprint.
    - Hybrid LED footprint (3 mm + 1206 twin + middle hole) on all four LED positions.
    - VU tap at the speaker terminal; its resistors beside the VU header.
    Boards: amp 134x86 / compact 100x98, PSU 90x58, vol 42x26, hp 42x30, panel 156x156; 2-layer boards and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
    [amp.kicad_pcb, amp.kicad_sch, amp_1layer.kicad_pcb, amp_compact.kicad_pcb, bom_all.csv, bom_amp.csv, bom_hp.csv, bom_mouser.csv]
