lahirunirmalx/discrete-stereo-amp/(notices)

Notices in the files:
kicad/panel/stereo-panel.kicad_pcb:
STEREO AMP + PSU + VOLUME + HEADPHONE v1.3 2026-11 CC BY-NC-SA 4.0
kicad/amp/amp_compact.kicad_pcb:
STEREO AMP 12V compact 100 mm wide CC BY-NC-SA 4.0
